majicdata6/ir_bingobox_2018/README.md

# ir_bingobox_2018
Infrared learning and sending.
