majicdata6/ir_bingobox_2018/project/Prudoction/[BingoBin]产品标贴制作说明书_171219.docx

档 号 | BGDC-518-01 | | 编 号 | BG-HRD18-0108025
保管期限 | 3年 | | 密 级 | 内部★
| | | 阶段标记 | V1.0.00

BingoBin网络功能模块

产品标贴制作说明书

## 1. 编写目的

本说明书定义了本产品使用标贴的制作规范。

本文档适用于公司员工。

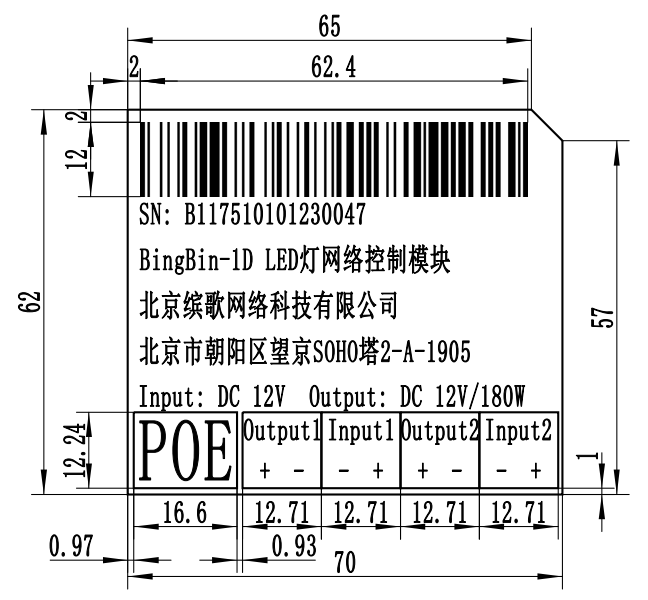
[picture p1: figure]

## 2. 标贴规格要求

### 2.1. 尺寸要求

图1

1、 尺寸：70 x 62 mm，右上角裁角。如图1所。
2、 条码：位置与尺寸如图1图示。要求如下：
- Code128-A规范
- 条码尺寸：62.4 x 12.0 mm
- 条码生成要求：只含条码（底部不带条码标签），居中对齐。如下图右图示，为正确格式。
- 位置：图1所示
- 条码内容与SN号相同
- 条码要求做流水号
- 参考：条码可以任选软件工具生成，遵循Code128规范即可。推荐使用Barcode Generator软件
3、 SN号：参考文档《[BingoBin]产品序列号编码说明书_171219》说明。例如B117510101230047，末六位做流水号处理，流水号段另见文件说明。
4、 流水号要求：要求保证条码内容与SN号相同。
5、 版本要求：参考提供的CAD样版文件。

### 2.2. 质量要求

1、 纸张材质：亚银龙
2、 工艺要求：
- 二次敷膜
- 背胶。温度要求：-40℃～+80℃

## 3. 文档编写

1、 编写者：开发部 朱海峰
2、 编写日期：2017年12月19日

## 4. 附录

### 4.1. 参考资料

1、 《[BingoBin]产品标贴样版_171219》
2、 《[BingoBin]产品SN号编码说明书_171219》
