majicdata6/ir_bingobox_2018/project/Prudoction/PCB制板/[BingoBin]PCB加工说明_180108.docx

档号 | BGDC-518-01 | | 编号 | BG-HRD18-0108005
保管期限 | 3年 | | 密级 | 内部★
| | | 阶段标记 | V1.0.00

# PCB加工说明表

BingoBin

文 件 名 | [BingoBin]HW_V1.0.10_180108.PcbDoc | 字 节 数 | 5317KB
设计软 件 | □Allegro □protel99 □protel 99SE □PADS □powerPCB ■DXP14 □AutoCAD □其它： | 表 面 处 理 | ■无铅喷锡 □镀金：oz
板 层 数 | □单面板 ■双面板 □多层板： | 插 头 镀 金 | □是 ■否
叠 层 顺 序 （多层板） | Layer1: Top Layer2: Bottom | 阻 焊 层 | □不涂阻焊剂 ■顶层阻焊 ■底层阻焊
| | 字 符 层 | □不印字符 ■顶层字符 ■底层字符
板 材 型 号 及基铜 | ■FR-4 □聚四氟乙稀 □Rogers □其它： | 外 形 公 差 | ■±0.15mm □0～—0.3mm □其它：mm
| 基 铜： ■无要求； □um | 制 板 数 量
板 厚 | 1.6 mm +/-10% | 下 单 日 期
| | 交 货 日 期
备 注 | 1、 PCB板尺寸：参考[BingoBin]HW_V1.0.10_180108.PcbDoc文件； 2、 板厚1.6 mm； 3、 阻焊颜色绿色； 4、 双层字符印刷，字符颜色白色； 5、 没有阻抗控制要求； 6、 双面开窗过孔不塞孔，双面未开窗小于等于0.4mm过孔全部塞孔；
