majicdata6/ir_bingobox_2018/project/Prudoction/SMT/软件/ReadMe.txt

固件

注：
	1、在调整灯的等级时，任意两个亮度等级变化时间均为5s。1-5级，1级最暗，5级最亮。
	2、电表的通信参数：9600波特率，偶校验，1个停止位。
