majicdata6/ir_bingobox_2018/project/Prudoction/SMT/钢网文件/ReadMe.txt

两个钢网文件，仅为从PCB Layout图中提取出的单板钢网文件，未做拼板。
请SMT时根据实际情况使用。
