majicdata6/ir_bingobox_2018/project/Prudoction/[BingoBin]建议工程配置说明书_171219.docx

档 号 | BGDC-518-01 | | 编 号 | BG-HRD18-0108027
保管期限 | 3年 | | 密 级 | 内部★
| | | 阶段标记 | V1.0.00

BingoBin网络功能模块

建议工程配置说明书

## 1. 编写目的

本说明书定义了生产应用本产品时安装配置说明。

本文档适用于公司员工。

## 2. 建议工程配置


### 2.1. LED灯安装配置

参考上图，建议连接配置方式如下表示：

序号 | 线路 | 连接说明
1 | Input1/Output1 | 连接室内LED灯，包含平板灯x3，筒灯x1，雨棚灯x1
2 | Input2/Output2 | 连接室外灯箱

收银台软件端将按此建议配置方式进行软件设计。

## 3. 文档编写

1、 编写者：开发部 朱海峰
2、 编写日期：2017年12月19日

## 4. 附录

### 4.1. 参考资料

1、 《[BingoBin]硬件产品需求说明书_171108》
2、 《[BingoBin]产品需求变更说明书_171219》
