majicdata6/ir_bingobox_2018/project/Prudoction/产品/[BingoBin]产品目录说明书_171219.docx

档 号 | BGDC-518-01 | | 编 号 | BG-HRD08-0108004
保管期限 | 3年 | | 密 级 | 内部★
| | | 阶段标记 | V1.0.00

BingoBin网络功能模块

产品目录说明书

## 1. 编写目的

本说明书定义了本产品系列与型号说明。

本文档适用于公司员工。

## 2. 产品目录

BingoBin网络功能模块为系统产品，产品硬件设计上做了兼容设计，可以衍生出四款产品。产品目录如下表说明。

序号 | 名称 | 型号 | 说明
1 | BingoBin网络功能模块 | BingoBin或BingoBin-1 | 产品系列型号
2 | BingoBin网络功能模块 智能电表版 | BingoBin-1B
3 | BingoBin网络功能模块 LED灯控版 | BingoBin-1D
4 | BingoBin网络功能模块 门锁版 | BingoBin-1M
5 | BingoBin网络功能模块 烟雾检测版 | BingoBin-1Y

## 3. 文档编写

1、 编写者：开发部 朱海峰
2、 编写日期：2017年12月19日

## 4. 附录

### 4.1. 参考资料

1、 《[BingoBin]硬件产品需求说明书_171108》
2、 《[BingoBin]产品需求变更说明书_171219》
