majicdata6/ir_bingobox_2018/project/Prudoction/SMT/PCB丝印图/[BingoBin]丝印文件_V1.0.10_180108.docx

档号 | BGDC-518-01 | | 编号 | BG-HRD18-0108015
保管期限 | 3年 | | 密级 | 内部★
| | | 阶段标记 | V1.0.10

[BingoBin]丝印文件

# 1. Top Layer

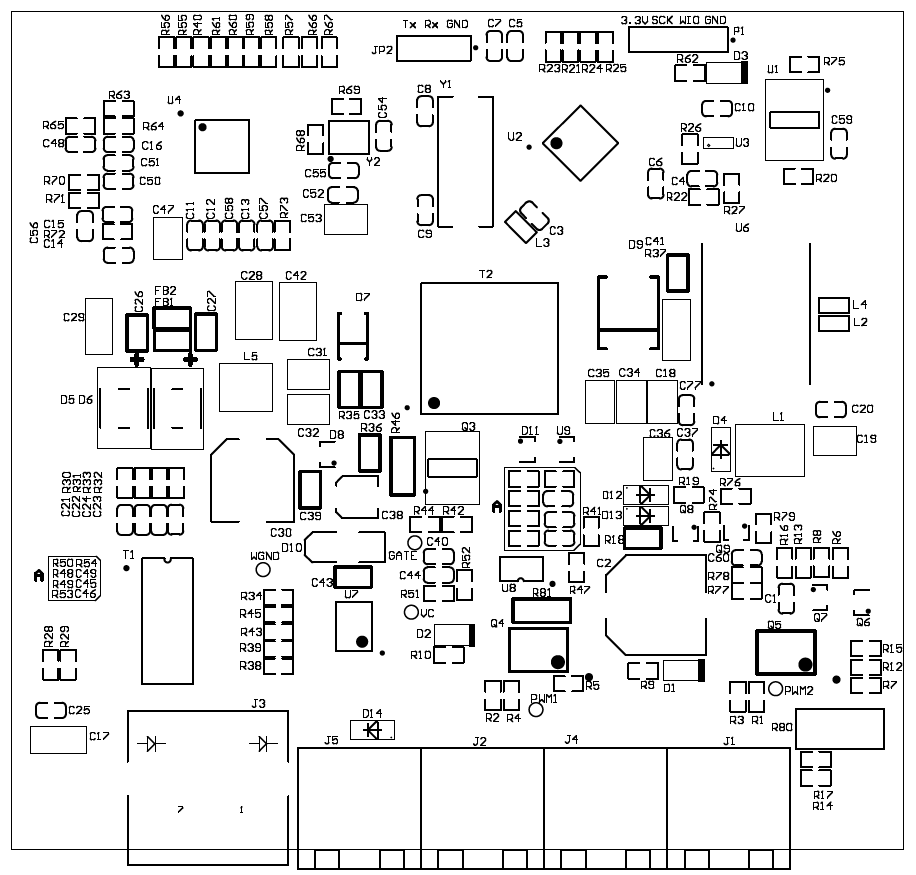
[picture p27: figure]

# 2. Bottom Layer

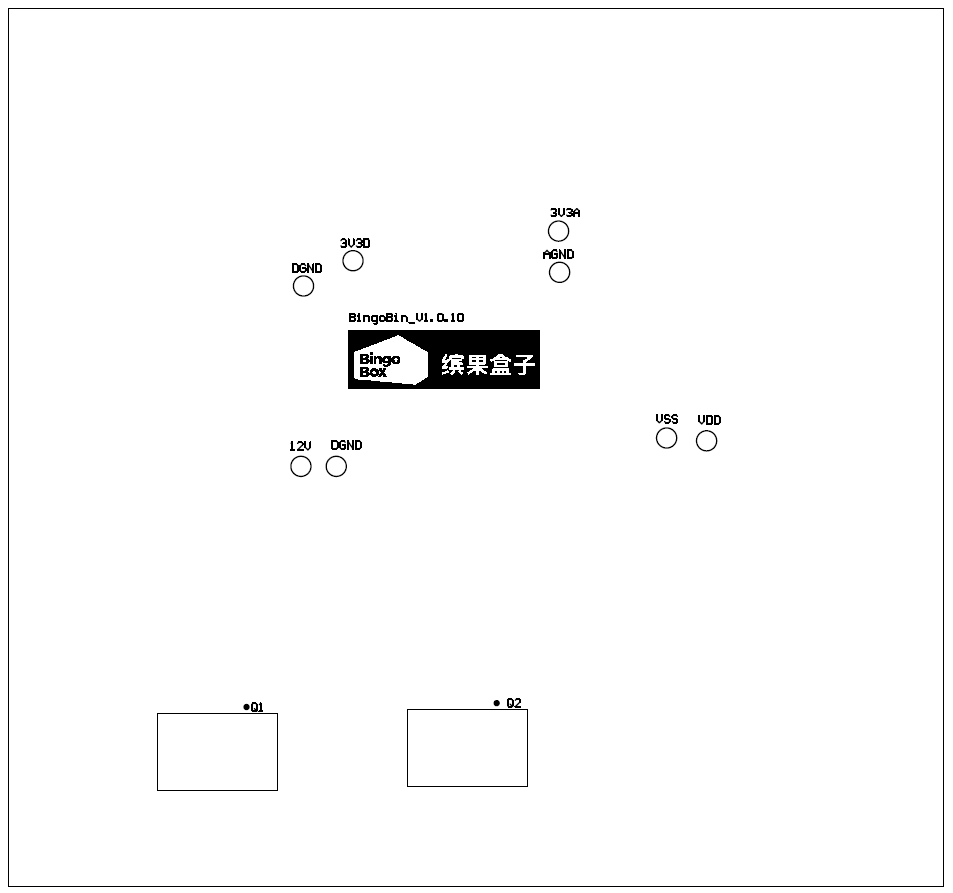
[picture p28: figure]
