majicdata6/ir_bingobox_2018/project/Prudoction/SMT/测试/[BingoBin]生产测试说明书_V1.0.00_180104.docx

档 号 | BGDC-518-01 | | 编 号 | BG-HRD18-0108018
保管期限 | 3年 | | 密 级 | 内部★
| | | 阶段标记 | V1.0.00

BingoBin网络功能模块

生产测试说明书

编写：开发部 朱海峰

序号 | 测试项目 | 测试说明 | 测试结果 | 备注
1 | 硬件短路测试 | 必测试项 万用表 对主板测试点进行短路测试 | 无任何短路现象即判断为合格 | 参考《[Bingobin]短路测试点说明_V1.0.10_180104》
2 | 上电测试 | 必测试项 电流表 对主板作瞬间上电操作 | 上电电流不超过30mA | 使用数字钳形电流表夹住POE网线
3 | 正式版软件测试 | 必测试项 主板烧录正式版软件，根据软件功能版本，按指导手册进行测试 | 指导手册测试荐全通过即判断为合格 | 参考《[BingoBin]生产测试指导手册_V1.0.10_180104》
