majicdata6/ir_bingobox_2018/project/Prudoction/SMT/坐标文件/[BingoBin]坐标文件_V1.0.10_180108.pdf

北京缤歌网络科技有限公司

第 1 页共 5 页

档号 | BGDC-518-01 | 编号 | BG-HRD18-0108016
保管期限 | 3 年 | 密级 | 内部★
| | 阶段标记 | V1.0.10

# [BingoBin]坐标文件

1. Top Layer
Designator | Mid X | Mid Y | Rotation
R10 | 1776mil | 790mil | 180.00
R6 | 3366mil | 1165mil | 90.00
C2 | 2617mil | 992mil | 0.00
C60 | 2985mil | 1185mil | 180.00
J3 | 798.189mil | 330mil | 270.00
C1 | 3146mil | 1019mil | 90.00
C59 | 3360mil | 2868mil | 90.00
C3 | 2123mil | 2575.999mil | 135.00
C4 | 2805.003mil | 2725.75mil | 180.00
C5 | 2045mil | 3265mil | 270.00
C6 | 2616mil | 2706mil | 90.00
C7 | 1960mil | 3265mil | 270.00
C8 | 1679mil | 3000mil | 90.00
C9 | 1679.291mil | 2597.992mil | 270.00
C10 | 2865.003mil | 3010.75mil | 180.00
C11 | 745mil | 2495mil | 270.00
C12 | 815mil | 2495mil | 270.00
C13 | 955mil | 2495mil | 270.00
C14 | 435mil | 2415mil | 180.00
C15 | 430mil | 2580mil | 180.00
C16 | 435mil | 2865mil | 180.00
C17 | 189.803mil | 445mil | 360.00
C18 | 2643mil | 1817.953mil | 90.00
C19 | 3342.953mil | 1660mil | 360.00
C20 | 3327.008mil | 1787.291mil | 360.00
C21 | 461mil | 1338.999mil | 270.00
C22 | 531mil | 1338.999mil | 270.00
C23 | 666mil | 1340mil | 270.00
C24 | 599mil | 1339mil | 270.00
C25 | 160mil | 565mil | 180.00
C26 | 510mil | 2098.598mil | 270.00
C27 | 789mil | 2101.598mil | 270.00
C28 | 984mil | 2188.772mil | 90.00
C29 | 357mil | 2126.197mil | 270.00
C30 | 979mil | 1499mil | 270.00
C31 | 1206.047mil | 1930mil | 180.00
C32 | 1206.047mil | 1787mil | 180.00

第 2 页共 5 页

C33 | 1461mil | 1869.598mil | 270.00
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
Y1 | 1843mil | 2795mil | 270.00
Y2 | 1370mil | 2893mil | 360.00
R5 | 2261mil | 673mil | 360.00
R81 | 2153.677mil | 972mil | 180.00
2. Bottom Layer
Designator | Mid X | Mid Y | Rotation
Q1 | 2857.953mil | 520mil | 270.00
Q2 | 1887.953mil | 535mil | 270.00

注意：坐标是以 PCB 板框左下角为基准点。
