majicdata6/ir_bingobox_2018/project/Design/SW/Doc/[BingoBin]测试用例大纲_V1.0.04.xlsx

测试用例 |  |  |  |  | 测试结果
3.功能测试
 | 3.1 供电测试
 |  | 3.1.1 POE供电测试
 |  | 3.1.2 外部供电测试
 | 3.2 网络通信测试
 |  | 3.2.1 心跳测试
 |  |  | 3.2.1.1 有心跳测试
 |  |  | 3.2.1.2 心跳时间间隔为5分钟
 | 3.3 设备操作测试
 |  | 3.3.1 读取设备信息测试
 |  | 3.3.2 更新IP测试
 | 3.4 外设功能测试
 |  | 3.4.1 采集环境温湿度功能测试
 |  |  | 3.4.1.1 采集环境温度信息
 |  |  |  | 3.4.1.1.1 -50℃温度采集测试
 |  |  |  | 3.4.1.1.2 -40℃温度采集测试
 |  |  |  | 3.4.1.1.3 20℃温度采集测试
 |  |  |  | 3.4.1.1.4 80℃温度采集测试
 |  |  |  | 3.4.1.1.5 100℃温度采集测试
 |  |  | 3.4.1.2 采集环境湿度信息
 |  |  |  | 3.4.1.2.1 0%RH湿度采集测试
 |  |  |  | 3.4.1.2.2 50%RH湿度采集测试
 |  |  |  | 3.4.1.2.3 99.9%RH湿度采集测试
 |  | 3.4.2 光传感器功能测试
 |  |  | 3.4.2.1 获取光照强度
 |  |  |  | 3.4.2.1.1 0 lux光照采集测试
 |  |  |  | 3.4.2.1.2 300 lux光照采集测试
 |  |  |  | 3.4.2.1.3 2000 lux光照采集测试
 |  |  |  | 3.4.2.1.4 10000 lux光照采集测试
 |  |  | 3.4.2.2 获取光照等级
 |  |  |  | 3.4.2.2.1 光强等级1测试
 |  |  |  | 3.4.2.2.2 光强等级3测试
 |  |  |  | 3.4.2.2.3 光强等级5测试
 |  | 3.4.3 人体红外传感器测试
 |  |  |  | 3.4.3.1人站在红外传感器正下方的有效检测范围测试
 |  |  |  | 3.4.3.2人站在红外传感器下方不确定的检测区域测试
 |  |  |  | 3.4.3.3人站在非有效检测区域测试
 |  | 3.4.4 LED灯测试
 |  |  | 3.4.4.1 打开LED
 |  |  |  | 3.4.4.1.1 POE供电打开LED灯
 |  |  |  | 3.4.4.1.2 外部供电打开LED灯
 |  |  | 3.4.4.2 关闭LED灯
 |  |  | 3.4.4.3 设置LED灯亮度等级
 |  |  |  | 3.4.4.3.1设置LED灯亮度为-1
 |  |  |  | 3.4.3.4.2设置LED灯亮度为0
 |  |  |  | 3.4.4.3.3设置LED灯亮度为1
 |  |  |  | 3.4.4.3.4设置LED灯亮度为3
 |  |  |  | 3.4.4.3.5设置LED灯亮度为5
 |  |  |  | 3.4.4.3.6设置LED灯亮度为6
 |  |  | 3.4.4.4 灯灭时查询LED灯状态信息
 |  | 3.4.5 门锁功能测试
 |  |  | 3.4.5.1 打开门锁
 |  |  | 3.4.5.2 关闭门锁
 |  |  | 3.4.5.3 设置自动关锁时间
 |  |  |  | 3.4.5.3.1 设置自动关锁时间(-1S)
 |  |  |  | 3.4.5.3.2 设置自动关锁时间(0S)
 |  |  |  | 3.4.5.3.3 设置自动关锁时间(4S)
 |  |  |  | 3.4.5.3.4 设置自动关锁时间(5S)
 |  |  |  | 3.4.5.3.5 设置自动关锁时间(60S)
 |  |  |  | 3.4.5.3.6 设置自动关锁时间(300S)
 |  |  |  | 3.4.5.3.7 设置自动关锁时间(301S)
 |  |  | 3.4.5.4 自动关锁测试
 |  |  |  | 3.4.5.4.1 自动关锁时间(6S)
 |  |  |  | 3.4.5.4.2 自动关锁时间(30S)
 |  |  | 3.4.5.5 查询门锁状态信息
 |  |  |  | 3.4.5.5.1 开门状态下，查询门锁状态信息
 |  |  |  | 3.4.5.5.2 关门状态下，查询门锁状态信息
 |  | 3.4.6 抄收电能表功能测试
 |  |  | 3.4.6.1 抄收电能设计(成功)
 |  |  | 3.4.6.2 抄收电能设计(失败)
 |  | 3.4.7 烟雾报警功能测试
 |  |  | 3.4.7.1 烟雾报警
 |  |  | 3.4.7.2 烟雾报警解除
 |  |  | 3.4.7.3 烟雾再次报警
 |  |  | 3.4.7.4 有烟雾每5分钟报警一次
4. 性能测试
 | 4.1 结构指标
 |  | 4.1.1 重量
 |  | 4.1.2 体积
5. 环境测试
 | 5.1 机械环境测试
 |  | 5.1.1 跌落（冲击）测试
 |  | 5.1.2 振动
 | 5.2 气候环境与可靠性测试
 |  | 5.2.1 高温测试
 |  |  | 5.2.1.1 贮存状态（不做）
 |  |  | 5.2.1.2 工作状态
 |  | 5.2.2 低温测试
 |  |  | 5.2.2.1 贮存状态（不做）
 |  |  | 5.2.2.2 工作状态
 |  | 5.2.3 温度冲击（不做）
 |  | 5.2.4 湿度（不做）
 |  | 5.2.5 防水测试（不做）
 | 5.3 特殊环境测试
 |  | 5.3.1 盐雾（不做）
 |  |  | 5.3.1.1 先决条件
 |  |  | 5.3.1.2 盐雾测试用例（不做）
