majicdata6/ir_bingobox_2018/project/Design/Feature/TB2vr54aV5N.eBjSZFKXXX_QVXa_!!1026500774.png

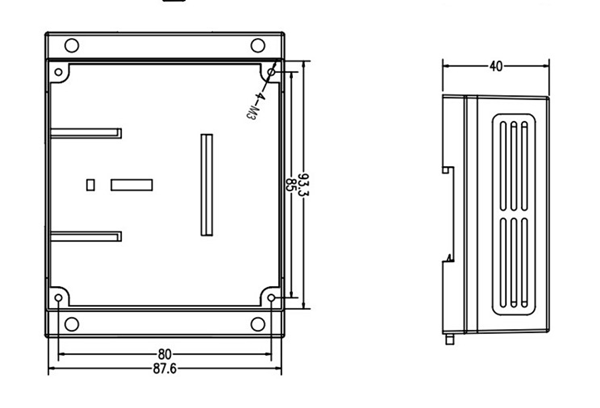
project/Design/Feature/TB2vr54aV5N.eBjSZFKXXX_QVXa_!!1026500774.png
