majicdata6/ir_bingobox_2018/project/Design/Feature/TB2xsKWa71M.eBjSZFOXXc0rFXa_!!1026500774.png

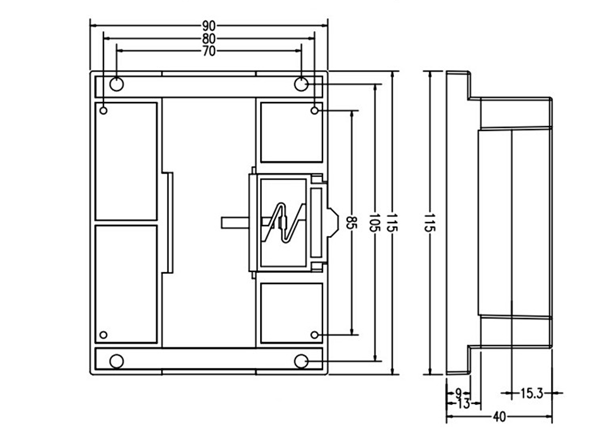
project/Design/Feature/TB2xsKWa71M.eBjSZFOXXc0rFXa_!!1026500774.png
