majicdata6/ir_bingobox_2018/project/Design/Feature/TB2ZWe0a71M.eBjSZFFXXc3vVXa_!!1026500774.png

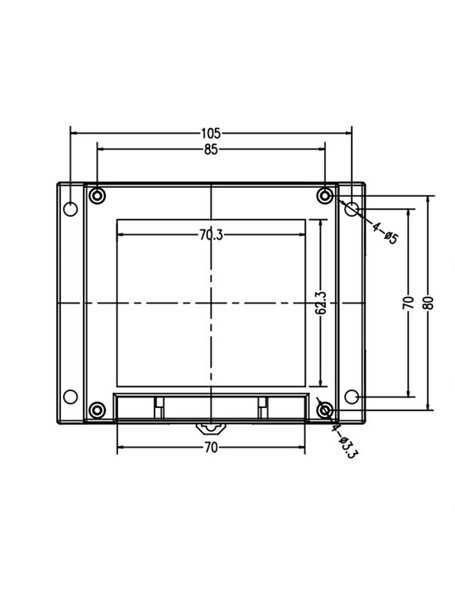
project/Design/Feature/TB2ZWe0a71M.eBjSZFFXXc3vVXa_!!1026500774.png
