majicdata6/ir_bingobox_2018/project/Design/Feature/TB20bi0a2OM.eBjSZFqXXculVXa_!!1026500774.png

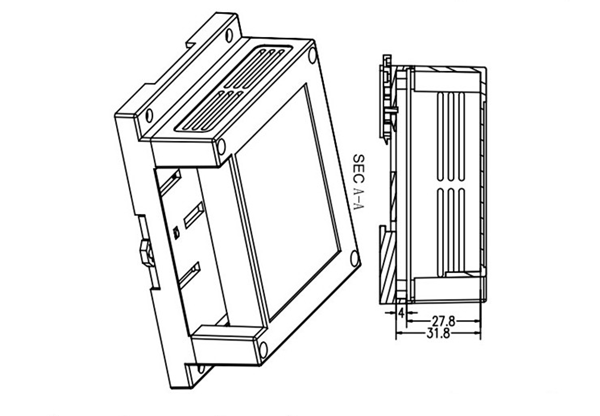
project/Design/Feature/TB20bi0a2OM.eBjSZFqXXculVXa_!!1026500774.png
