majicdata6/ir_bingobox_2018/project/Design/HW/Datasheet/上海联捷/LG635-6.35（拼接）.jpg

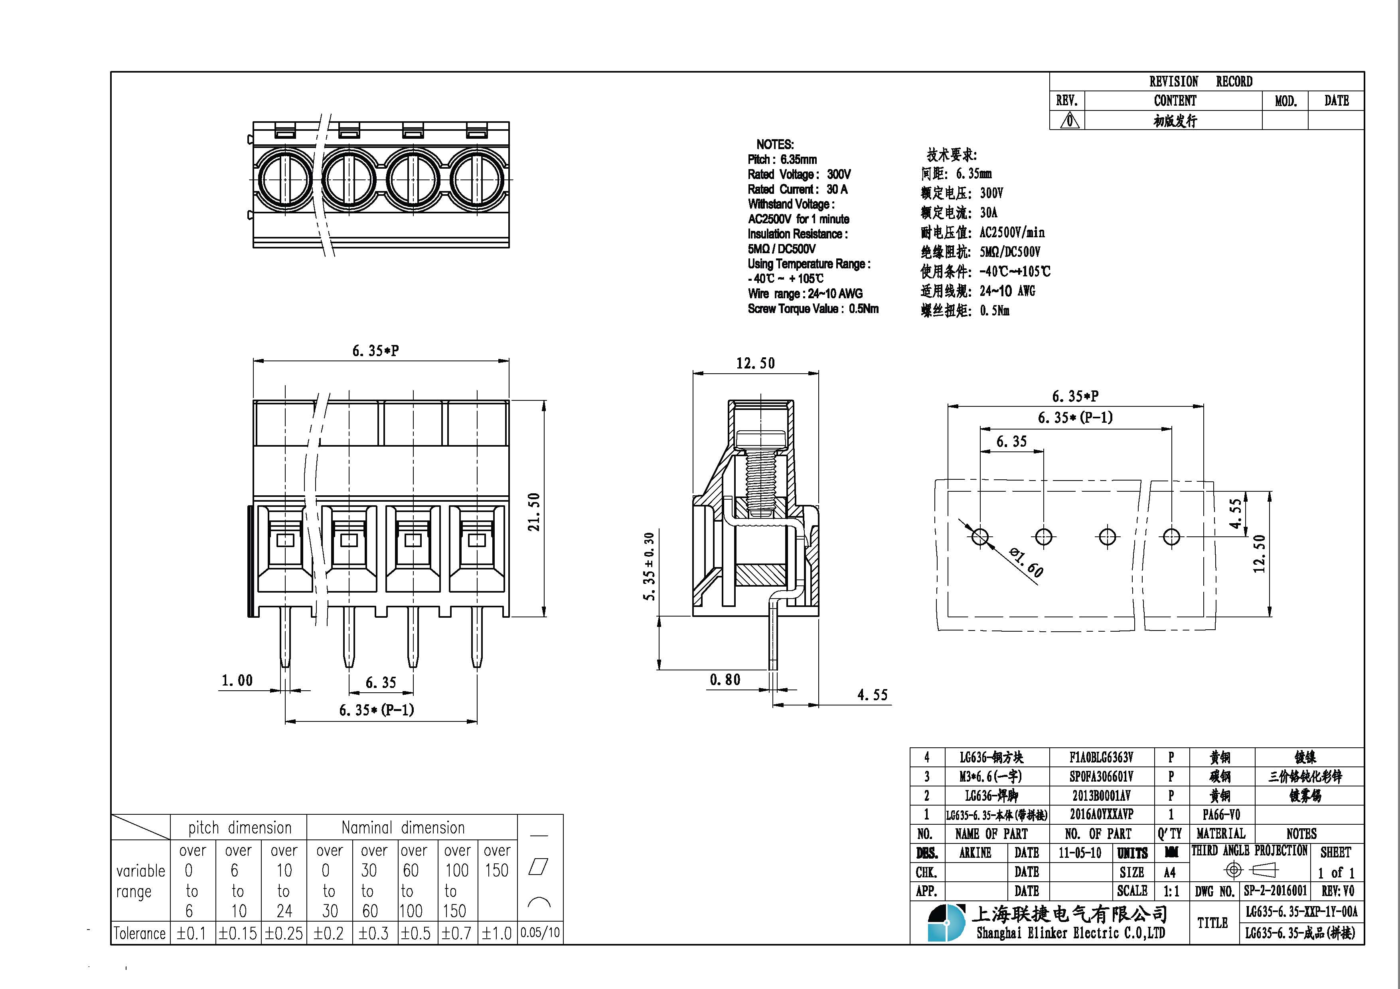
project/Design/HW/Datasheet/上海联捷/LG635-6.35（拼接）.jpg
