majicdata6/ir_bingobox_2018/project/Design/HW/Datasheet/上海联捷/LG762-7.62.jpg

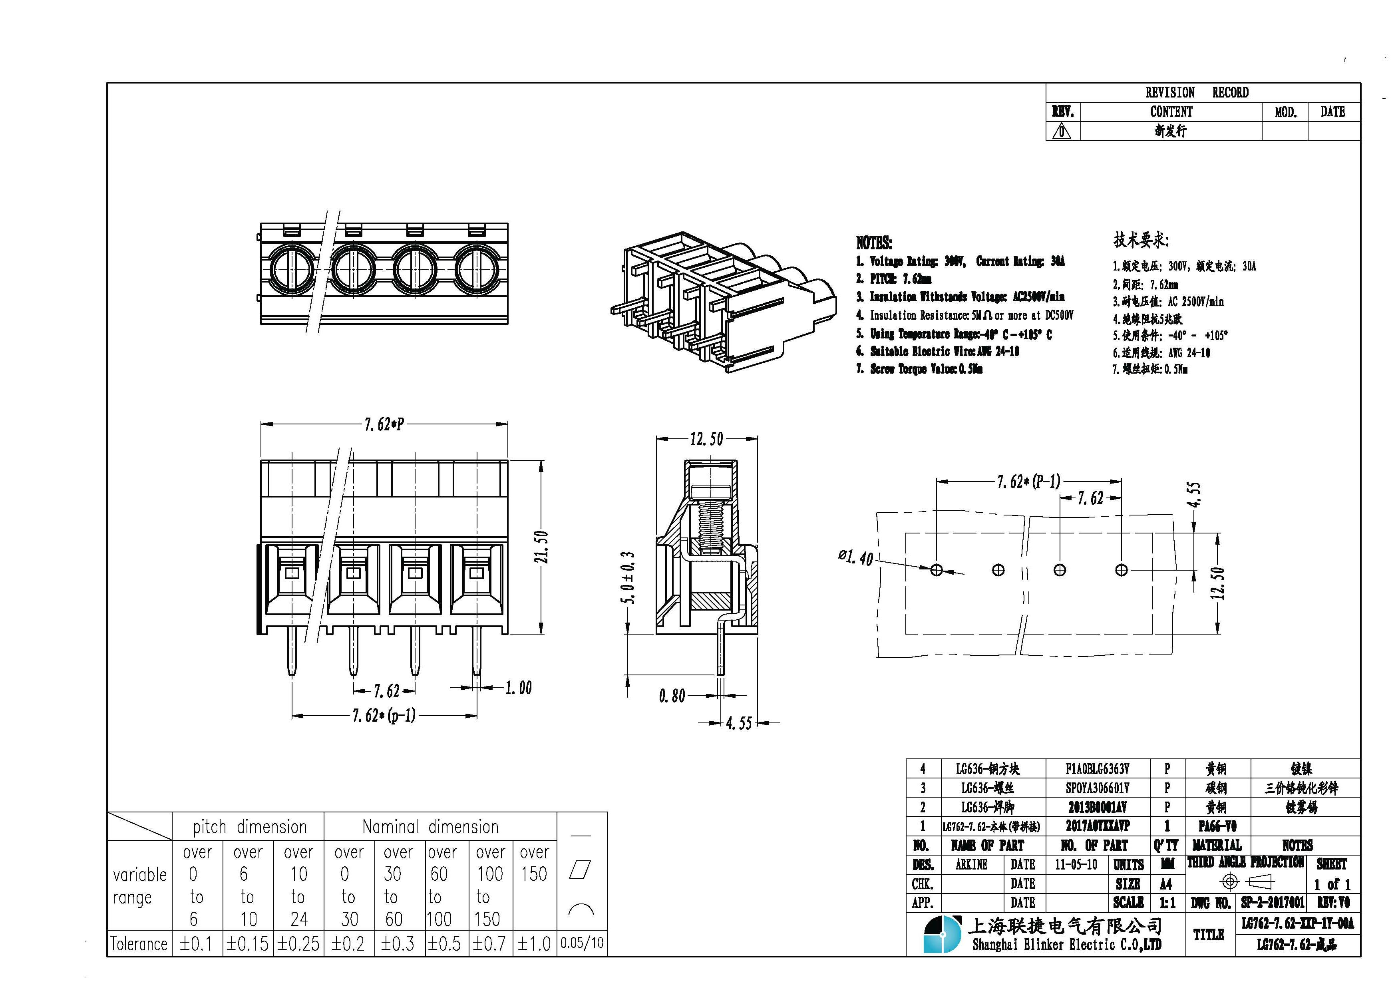
project/Design/HW/Datasheet/上海联捷/LG762-7.62.jpg
