majicdata6/ir_bingobox_2018/project/Design/HW/Datasheet/上海联捷/LG952-9.52（带拼接）.jpg

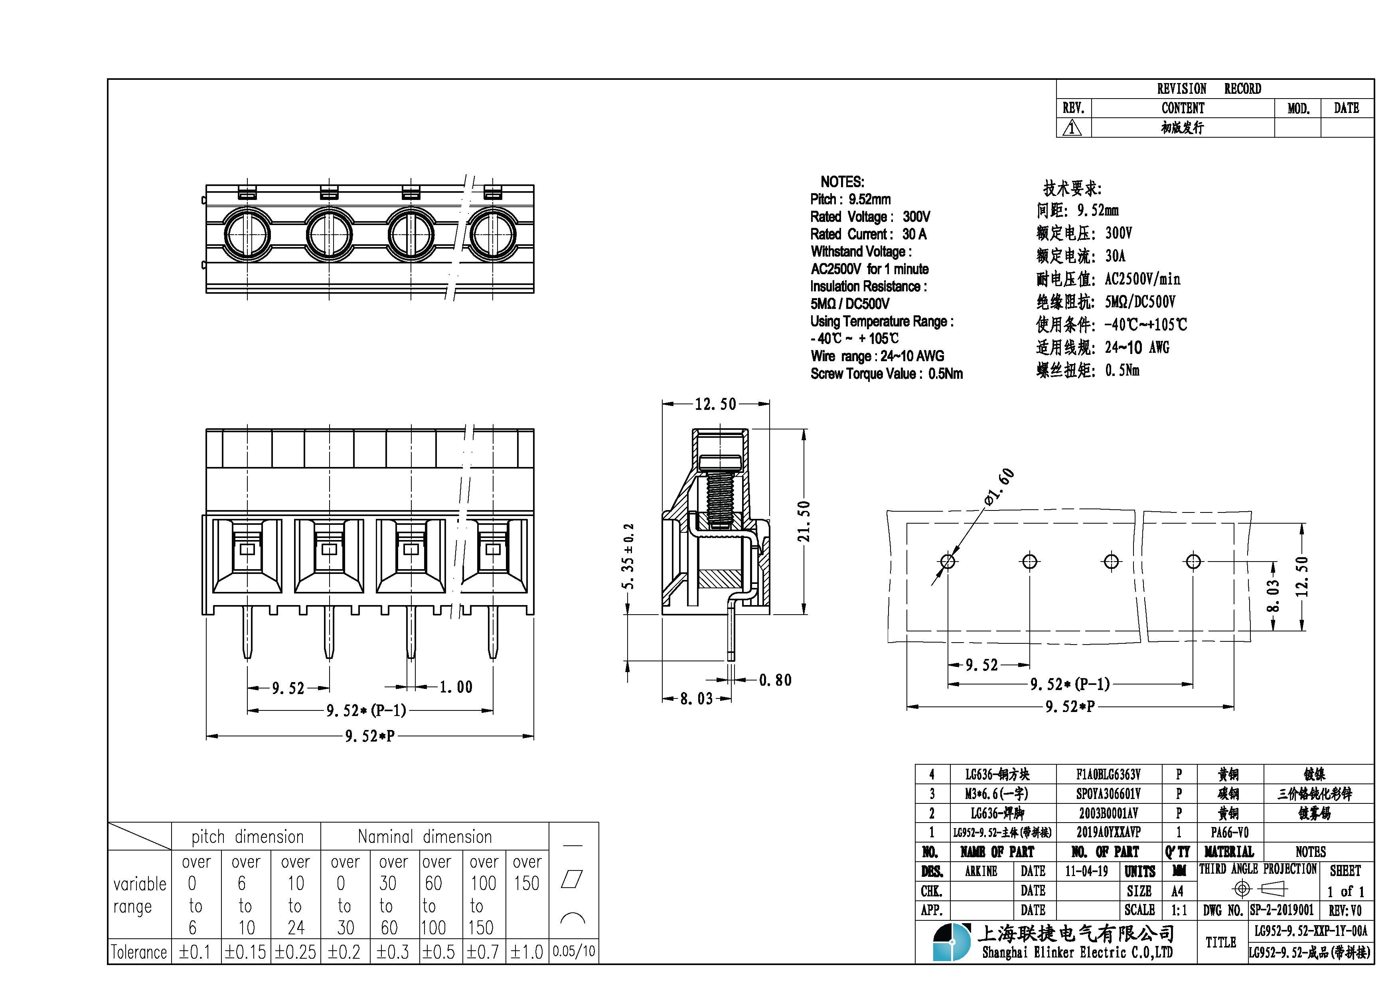
project/Design/HW/Datasheet/上海联捷/LG952-9.52（带拼接）.jpg
