majicdata6/ir_bingobox_2018/project/Design/HW/Datasheet/上海联捷/LW1C-11.0.jpg

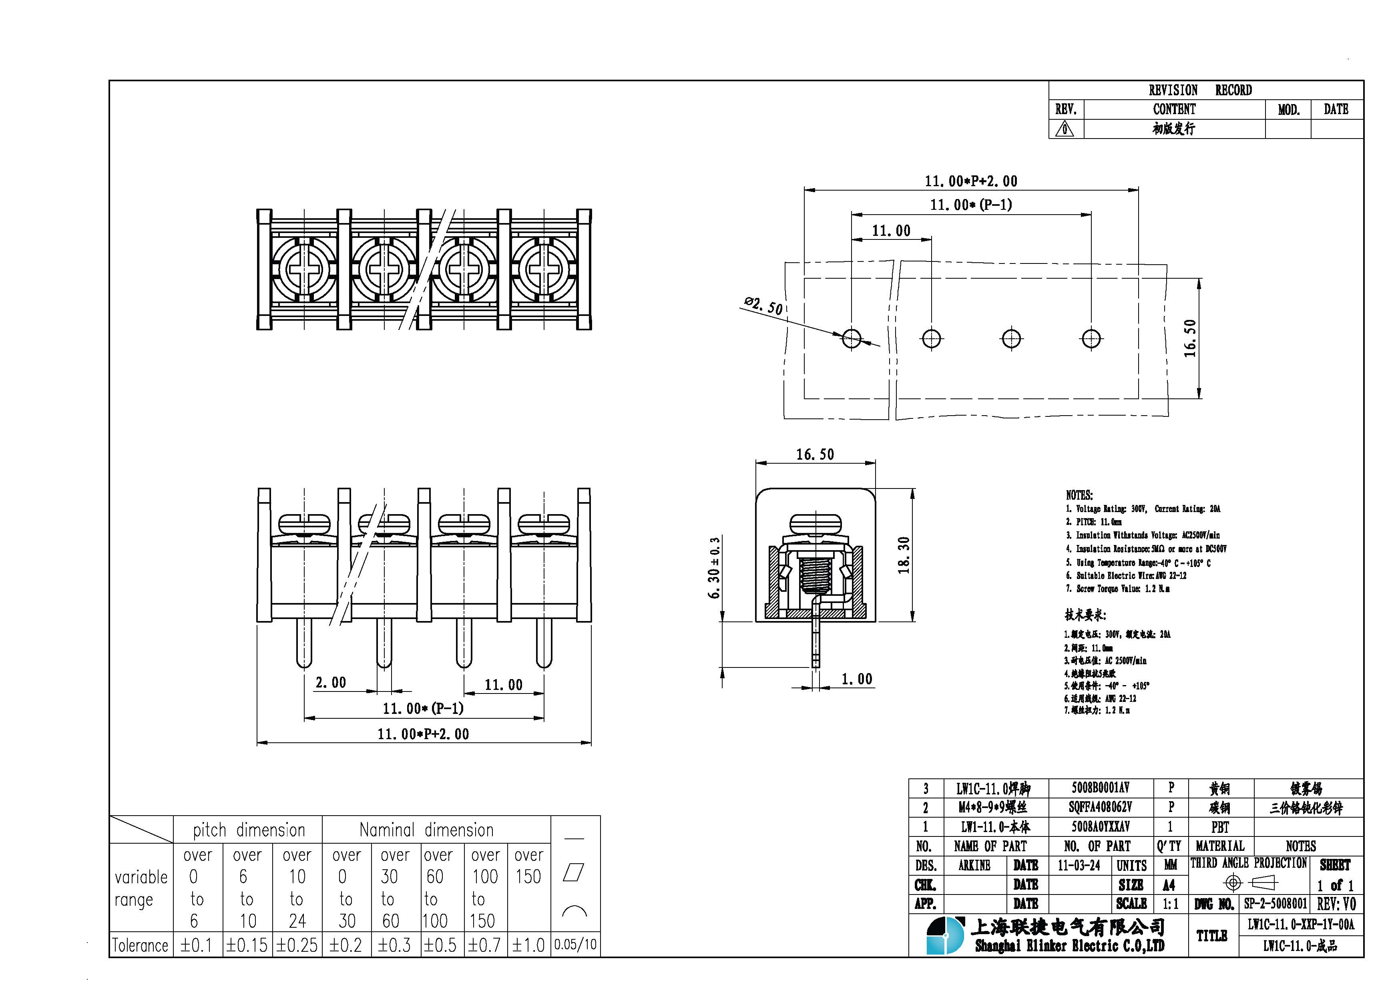
project/Design/HW/Datasheet/上海联捷/LW1C-11.0.jpg
