majicdata6/ir_bingobox_2018/project/Design/HW/Datasheet/上海联捷/联捷LG系列CE.jpg

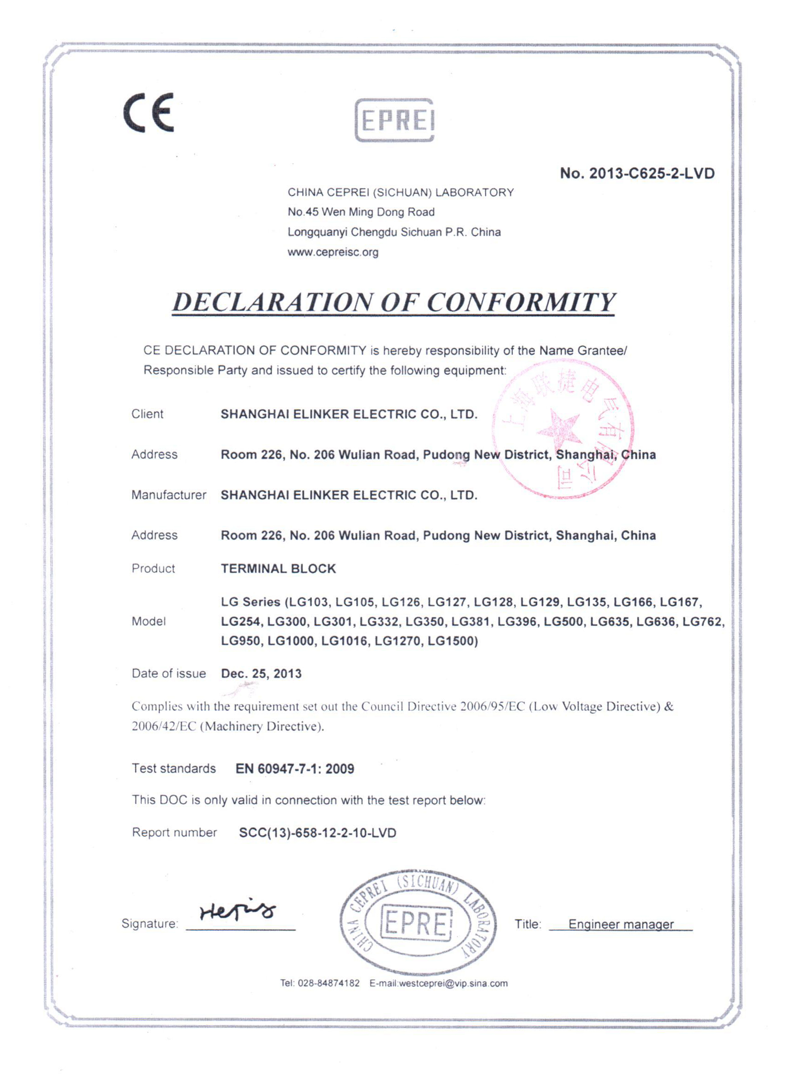
project/Design/HW/Datasheet/上海联捷/联捷LG系列CE.jpg
