majicdata6/ir_bingobox_2018/project/Design/HW/Doc/[BingoX]BOM_Model_170919.xlsx

[BingoBin]BOM
制作： |  |  |  |  |  |  |  |  | 日期：2017年9月19日
序号 | 类别 | 物料编号 | 物料名称 | 标号 | 型号/规格 | 封装 | 用量 | 厂商 | 厂商编码 | 厂商(替代料) | 厂商编码(替代料) | 厂商料号 | 备注
1 | 电子料 |  | 贴片电容 | C1, C37, C49 | Capacitor, Ceramic, 1uF, 25V, 10%, 0603, X7R | 0603 | 3 | muRata(村田) | GRM188R61E105KA12D
2 | 电子料 |  | 贴片电容 | C2, C8, C11, C13, C16, C20, C21, C22, C23, C24, C25,C40, C50, C51, C52, C56, C57, C58, C59, C60, C61, C66, C71, C72, C75, C76, C77 | Capacitor, Ceramic, 0.1uF, 16V, 10%, 0603, X7R | 0603 | 27 | AVX | 0603YC104KAT2A
3 | 电子料 |  | 贴片电容 | C21,C22,C23,C24 | Capacitor, Ceramic, 0.1uF, 100V, 10%, 0603, X7R | 0603 | 4 | muRata(村田) | GRM21BR72A104KAC4L
4 | 电子料 |  | 贴片电容 | C3, C7, C9, C10, C14, C46,C70, C73 | Capacitor, Ceramic, 0.01uF, 50V, 10%, 0603, X7R | 0603 | 8 | SAMAUNG(三星) | CL10B103KB8NNNC
5 | 电子料 |  | 贴片电容 | C5 | Capacitor, Ceramic, 10uF, 10V, 10%, 0603, X5R | 0603 | 1 | muRata(村田) | GRM188R61A106KE69D
6 | 电子料 |  | 贴片电容 | C6 | Capacitor, Ceramic, 5000pF, 50V, 10%, 0603, X7R | 0603 | 1 | FH(风华) | 0603B502K500NT
7 | 电子料 |  | 贴片电容 | C53 | Capacitor, Ceramic, 470nF, 16V, 10%, 0603, X7R | 0603 | 1 | SAMAUNG(三星) | CL10B474KO8NNNC
8 | 电子料 |  | 贴片电容 | C54, C55 | Capacitor, Ceramic, 22pF, 50V, 5%, 0603, COG | 0603 | 2 | 'muRata(村田) | GRM1885C1H220JA01D
9 | 电子料 |  | 贴片电容 | C63 | Capacitor, Ceramic, 22nF, 25V, 10%, 0603, X7R | 0603 | 1 | muRata(村田) | GRM188R71E223KA01D
10 | 电子料 |  | 贴片电容 | C68, C69 | Capacitor, Ceramic, 18pF, 50V, 5%, 0603, COG | 0603 | 2 | muRata(村田) | GRM1885C1H180JA01D
11 | 电子料 |  | 贴片电容 | C64, C65 | Capacitor, Ceramic, 6.8nF, 50V, 10%, 0603, X7R | 0603 | 2 | YAGEO(国巨) | CC0603KRX7R9BB682
12 | 电子料 |  | 贴片电容 | C12,C74 | Capacitor, Ceramic, 4.7uF, 16V, 10%, 0603, X7R | 0603 | 2 | muRata(村田) | GRM188R61C475KE11D
13 | 电子料 |  | 贴片电容 | C44 | Capacitor, Ceramic, 0.033uF, 50V, 10%, 0603, X7R | 0603 | 1 | SAMAUNG(三星) | CL10B333KB8NNNC
14 | 电子料 |  | 贴片电容 | C45 | Capacitor, Ceramic, 100pF, 50V, 5%, 0603, X7R | 0603 | 1 | muRata(村田) | GRM1882C1H101JA01D
15 | 电子料 |  | 贴片电容 | C33, C43 | Capacitor, Ceramic, 0.1uF,100V, 10%,0805,X7R | 0805 | 2 | muRata(村田) | GRM21BR72A104KAC4L
16 | 电子料 |  | 贴片电容 | C39 | Capacitor, Ceramic, 0.22uF,25V, 10%,0805,X7R | 0805 | 1 | SAMAUNG(三星) | CL21B224KAFNNNE
17 | 电子料 |  | 贴片电容 | C41 | Capacitor, Ceramic, 680pF,50V,5%,0805, NPO | 0805 | 1 | YAGEO(国巨) | CC0805JRNPO9BN681
18 | 电子料 |  | 贴片电容 | C26, C27, C47, C48 | Capacitor, Ceramic, 1000pF,100V, 10%,0805,X7R | 0805 | 4 | SAMAUNG(三星) | CL21B102KCANNNC
19 | 电子料 |  | 贴片电容 | C4, C18, C19, C34, C35, C36, C62, C67 | Capacitor, Ceramic, 22uF,16V, 10%,1210,X5R | 1210 | 8 | muRata(村田) | GRM32ER61C226KE20L
20 | 电子料 |  | 贴片电容 | C31, C32 | Capacitor, Ceramic, 2.2uF,100V, 10%,1210,X7R | 1210 | 2 | muRata(村田) | GRM32ER72A225KA35L
22 | 电子料 |  | 贴片电容 | C17, C29 | Capacitor, Ceramic Chip,1000pF, 2KV, 10%,1808 | 1808 | 2 | muRata(村田) | GR442QR73D102KW01L
23 | 电子料 |  | 贴片电容 | C28, C42 | Capacitor, Ceramic, 2200pF,2KV, 20%,1812,X7R | 1812 | 2 | muRata(村田) | GR443QR73D222KW01L
25 | 电子料 |  | 贴片铝聚合物电容 | C30 | Capacitor, Aluminum Electrolytic, 22uF,100V, 20% | 8*10.2mm | 1 | EEEFK1E100R | Panasonic
26 | 电子料 |  | 贴片铝聚合物电容 | C38 | Capacitor, Aluminum,10uF, 25V, 20% | 4*5.8 | 1 | EEEFK2A220P | Panasonic
26 | 电子料 |  | 贴片铝聚合物电容 | C80 | Capacitor, Aluminum Electrolytic, 470uF,16V, 20% | C8*10.2MM | 1
27 | 电子料 |  | 贴片电阻 | R1, R2, R4, R11, R20, R25, R26, R48, R53, R57, R58, R59, R67, R68, R74, R75, R76, R77, R78, R79, R80, R81, R82, R83 | RES, THICK FILM, 10K, 5%, 1/10W, 0603 | 0603 | 24 | YAGEO(国巨) | RC0603JR-0710KL
28 | 电子料 |  | 贴片电阻 | R6, R47, R51 | RES, THICK FILM, 2K, 5%, 1/10W, 0603 | 0603 | 3 | YAGEO(国巨) | RC0603JR-072KL
29 | 电子料 |  | 贴片电阻 | R3,R7, R12, R17,R69 | RES, THICK FILM, 1M, 5%, 1/10W, 0603 | 0603 | 6 | YAGEO(国巨) | RC0603JR-071ML
30 | 电子料 |  | 贴片电阻 | R8 | RES, THICK FILM, 470K, 5%, 1/10W, 0603 | 0603 | 1 | YAGEO(国巨) | RC0603JR-07470KL
31 | 电子料 |  | 贴片电阻 | R9 | RES, THICK FILM, 6.8K, 5%, 1/10W, 0603 | 0603 | 1 | YAGEO(国巨) | RC0603FR-076K8L
32 | 电子料 |  | 贴片电阻 | R5,R10, R14 | RES, THICK FILM, 18K, 1%, 1/10W, 0603 | 0603 | 3 | YAGEO(国巨) | RC0603FR-0718KL
33 | 电子料 |  | 贴片电阻 | R13, R24, R44,R56, | RES, THICK FILM, 1K, 5%, 1/10W, 0603 | 0603 | 4 | YAGEO(国巨) | RC0603JR-071KL
34 | 电子料 |  | 贴片电阻 | R18,R19, R21, R55, R84 | RES, THICK FILM, 4.7K, 5%, 1/10W, 0603 | 0603 | 5 | YAGEO(国巨) | RC0603JR-074K7L
 | 电子料 |  | 贴片电阻 | R85 | RES, THICK FILM, 10M, 5%, 1/10W, 0603 | R0603 | 1 | YAGEO(国巨) | RC0603FR-0710ML
 | 电子料 |  | 贴片电阻 | R86 | RES, THICK FILM, 1.5M, 5%, 1/10W, 0603 | R0603 | 1 | YAGEO(国巨) | RC0603JR-071M5L
 | 电子料 |  | 贴片电阻 | R95 | RES, THICK FILM, 2.2K, 5%, 1/8W, 0805 | 0805 | 1 | YAGEO(国巨) | RC0603JR-072K2L
36 | 电子料 |  | 贴片电阻 | R27 | RES, THICK FILM, 120 OHM, 5%, 1/10W, 0603 | 0603 | 1 | YAGEO(国巨) | RC0603JR-07120RL
37 | 电子料 |  | 贴片电阻 | R15 | RES, THICK FILM, 47K, 1%, 1/10W, 0603 | 0603 | 1 | YAGEO(国巨) | RC0603FR-0747KL
38 | 电子料 |  | 贴片电阻 | R61, R62 | RES, THICK FILM, 680 OHM, 5%, 1/10W, 0603 | 0603 | 2 | YAGEO(国巨) | RC0603JR-07680RL
39 | 电子料 |  | 贴片电阻 | R64, R65 | RES, THICK FILM, 49.9 OHM, 1%, 1/10W, 0603 | 0603 | 2 | YAGEO(国巨) | RC0603FR-0749R9L
40 | 电子料 |  | 贴片电阻 | R28, R29 | RES, THICK FILM, 330 OHM, 5%, 1/10W, 0603 | 0603 | 1 | YAGEO(国巨) | RC0603JR-07330RL
41 | 电子料 |  | 贴片电阻 | R73 | RES, THICK FILM, 12.4K, 1%, 1/10W, 0603 | 0603 | 1 | UniOhm台湾厚声 | 0603WAF1242T5E
42 | 电子料 |  | 贴片电阻 | R71, R72 | RES, THICK FILM, 82 OHM, 5%, 1/10W, 0603 | 0603 | 2 | UniOhm台湾厚声 | 0603WAJ0820T5E
43 | 电子料 |  | 贴片电阻 | R23 | RES, THICK FILM, 100 OHM, 5%, 1/10W, 0603 | 0603 | 1 | YAGEO(国巨) | RC0603JR-07100RL
44 | 电子料 |  | 贴片电阻 | R30, R31, R32, R33 | RES, THICK FILM, 75 OHM, 1%, 1/10W, 0603 | 0603 | 4 | YAGEO(国巨) | RC0603FR-0775RL
45 | 电子料 |  | 贴片电阻 | R34 | RES, THICK FILM, 24.9K, 1%, 1/10W, 0603 | 0603 | 1 | UniOhm台湾厚声 | 0603WAF249JT5E
46 | 电子料 |  | 贴片电阻 | R38 | RES, THICK FILM, 59K, 1%, 1/10W, 0603 | 0603 | 1 | UniOhm台湾厚声 | 0603WAF5902T5E
47 | 电子料 |  | 贴片电阻 | R39 | RES, THICK FILM, 80.6K, 1%, 1/10W, 0603 | 0603 | 1 | UniOhm台湾厚声 | 0603WAF8062T5E
48 | 电子料 |  | 贴片电阻 | R40 | RES, THICK FILM, 392K, 5%, 1/10W, 0603 | 0603 | 1 | UniOhm台湾厚声 | 0603WAF3923T5E
49 | 电子料 |  | 贴片电阻 | R22, R41, R60, R63, R70 | RES, THICK FILM, 0 OHM, 1%, 1/10W, 0603 | 0603 | 5 | YAGEO(国巨) | AC0603FR-070RL
50 | 电子料 |  | 贴片电阻 | R42,R66 | RES, THICK FILM, 10 OHM, 5%, 1/10W, 0603 | 0603 | 2 | YAGEO(国巨) | RC0603JR-0710RL
51 | 电子料 |  | 贴片电阻 | R43 | RES, THICK FILM, 39.2K, 1%, 1/10W, 0603 | 0603 | 1 | UniOhm台湾厚声 | 0603WAF3922T5E
52 | 电子料 |  | 贴片电阻 | R45 | RES, THICK FILM, 90.9 OHM, 1%, 1/10W, 0603 | 0603 | 1 | UniOhm台湾厚声 | 0603WAF9092T5E
53 | 电子料 |  | 贴片电阻 | R50 | RES, THICK FILM, 44.2K, 1%, 1/10W, 0603 | 0603 | 1 | UniOhm台湾厚声 | 0603WAF4422T5E
54 | 电子料 |  | 贴片电阻 | R52 | RES, THICK FILM, 1.5K, 5%, 1/10W, 0603 | 0603 | 1 | YAGEO(国巨) | RC0603JR-071K5L
55 | 电子料 |  | 贴片电阻 | R54 | RES, THICK FILM, 11.5K, 1%, 1/10W, 0603 | 0603 | 1 | UniOhm台湾厚声 | 0603WAF1152T5E
56 | 电子料 |  | 贴片电阻 | R49 | RES, THICK FILM, 4.99K, 1%, 1/10W, 0603 | 0603 | 1 | YAGEO(国巨) | RC0603FR-074K99L
57 | 电子料 |  | 贴片电阻 | R35 | RES, THICK FILM, 39K, 1%, 1/8W, 0805 | 0805 | 1 | YAGEO(国巨) | RC0805FR-0739KL
58 | 电子料 |  | 贴片电阻 | R36 | RES, THICK FILM, 10 OHM, 1%, 1/8W, 0805 | 0805 | 1 | YAGEO(国巨) | RC0805FR-0710RL
59 | 电子料 |  | 贴片电阻 | R37 | RES, THICK FILM, 20 OHM, 5%, 1/2W, 2010 | 2010 | 1 | UniOhm台湾厚声 | 2010W2J0200T4S
60 | 电子料 |  | 贴片电阻 | R46 | RES, THICK FILM, 0.39 OHM, 1%, 3/4W, 2010 | 2010 | 1 | YAGEO(国巨) | PT2010FK-070R39L
61 | 电子料 |  | 插针 | JP2, JP4,JP7 | Header, 3-Pin, Single row | HDR1X3 | 3
62 | 电子料 |  | 插针 | JP5,JP6,JP8 | Header, 2-Pin, Single row | HDR1X2 | 3
63 | 电子料 |  | 被动式红外传感器 | J1 | 热释电传感器 | TO-5 | 1 | Winsen(炜盛) | RD624
64 | 电子料 |  | RJ45连接器 | J3 | RJ45连接器/RJ45网口连接器,8p8c,90°,黄-绿LED灯,镀金,带屏蔽 | RJ45LED | 1 | TE Connectivity | 2-406549-1 | CONNFLY | DS1128-09-S8B8X
65 | 电子料 |  | 电源插座 | J4 | DC005-2.5MM | 2.5mm | 1 | SOFNG(台湾硕方) | DC连接器/DC005-2.5MM A级
66 | 电子料 |  | 15EDG座 | J2,J8 | WJ15EDGVC-3.81-2P | 15EDG-2P | 2 |  | WJ15EDGVC-2P
67 | 电子料 |  | 烟雾传感器接口 | J5 | WJ15EDGVC-3.81-4P | 15EDG-4P | 1 |  | WJ15EDGVC-4P
68 | 电子料 |  | JTAG座 | J6 | JTAG | IDC14P-2.54 | 1
70 | 电子料 |  | LED | D2, D13 | 翠绿色 贴片LED ( Iv=220-270mcd @IF=5mA) | 0805 | 2 | 国星光电 | FC-2012UGK-520D5
71 | 电子料 |  | 贴片二极管 | D3 | Diode Schottky, 60V, 5A, SMC | SMC | 1 | DIODES | B560C-13-F
72 | 电子料 |  | 贴片二极管 | D4, D15 | Diode Schottky, 40V,1A | SOD123 | 2 | DIODES | 1N5819HW
73 | 电子料 |  | 桥式整流器 | D5, D6 | Bridge Rectifier, 100V, 0.8A, Glass Passivated, SMD | MINI DIP4 | 2 | DIODES | HD01
74 | 电子料 |  | 贴片二极管 | D7, D12 | Diode, Rectifier, 1A, 200V | SMA | 2 | On Semi | MURA120 | MDD | SS1200
75 | 电子料 |  | 贴片二极管 | D8 | Diode, Switching, 200mA, 75V, 225mW | SOT-23 | 1 | DIODES | BAS16-7 | LRC(乐山无线电) | LBAS16LT1G
76 | 电子料 |  | 贴片二极管 | D9 | Diode Schottky, 60V, 3A, SMC | SMC | 1 | DIODES | B360C-13-F | ON(安森美) | MBRS360T3G
77 | 电子料 |  | 贴片二极管 | D10 | Diode,Transient Voltage Suppressor,400W,58V | SMA | 1 | DIODES | SMAJ58A
78 | 电子料 |  | 贴片二极管 | D11 | Diode, Dual Schottky, 200mA, 30V | SOT-23 | 1 | DIODES | BAT54S
80 | 电子料 |  | 铁氧体磁珠 | FB1, FB2, FB3, FB4 | Bead, Ferrite, SMT, 220 Ohms, 3A | 0805 | 4 | TDK | MPZ2012S221A
81 | 电子料 |  | 电感 | L1 | 330uH功率电感 | 5*5mm | 1 | LC | SMNR5040-331MT
82 | 电子料 |  | 电感 | L5 | Inductor, SMT, 750mA, 350 milliohm,10uH | 4x4mm | 1 | Coilcraft | LPS4012-103ML | Sunlord(顺络) | SWPA4012S100M
83 | 电子料 |  | 铁氧体磁珠 | L2, L3, L4 | Bead, Ferrite, SMT, 120 Ohms, 3A | 0603 | 3 | muRata(村田) | BLM03AG121SN1D
84 | 电子料 |  | N-MOS管 | Q1, Q2 | MOSFET, N-ch, 40-V, 50A, 7 milliOhms | TO252 | 2 | ALPHA&OMEGA | AOD4184A
85 | 电子料 |  | N-MOS管 | Q3 | MOSFET, N-ch, 150-V, 4.1A, 66 milliOhms | SO8 | 1 | Fairchild | FDS2582
 | 电子料 |  | N-MOS管 | Q4 | MOSFET, N-ch, 30-V, 5.6A, 27 milliOhms | SOT-23 | 1 |  | CJ3400
87 | 电子料 |  | POE网络变压器 | T1 | XFMR, 1000 Base-T, Ratio 1:1 | 0.500 x 0.370 inch | 1 | Pulse | H2019
88 | 电子料 |  | 反激式变压器 | T2 | Transformer, Flyback For PoE, 12V, 1A | POE13P-12L | 1 | Coilcraft | POE13P-12L | HANRUN(汉仁) | HR051142
89 | 电子料 |  | IC | U1 | 红外传感信号处理器 | SOIC16 | 1 | TM(天微) | TM2291
90 | 电子料 |  | IC | U2 | LIGHT-TO-DIGITAL CONVERTER | TMB-6 | 1 | TAOS | TSL2561T
93 | 电子料 |  | IC | U5 | +3.3V Low Power Half-Duplex RS-485 Transceiver with 10Mbps Data Rate | SOIC8 | 1 | EXAR | SP3485EN-L/TR
94 | 电子料 |  | IC | U6 | SIMPLE SWITCHER® 1A Step-Down Voltage Regulator | TO-263-5 | 1 | TI | LM2575SX-3.3/NOPB
95 | 电子料 |  | IC | U7 | IC, IEEE 802.3af Integrated Primary Side Controller | TPS23753a | 1 | TI | TPS23753APW
96 | 电子料 |  | IC | U8 | IC, Photocoupler, 3750VRMS, 80-160% CTR | SSOP4 | 1 | Vishay | TCMT1107
97 | 电子料 |  | IC | U9 | IC, Shunt Regulator, 2.5V Ref, 36V, 100mA, 1% | SOT-23 | 1 | TI | TL431AIDBZR
98 | 电子料 |  | IC | U10 | 混合信号微控制器 | TSSOP-38 | 1 | TI | MSP430FR5727IDAR
99 | 电子料 |  | IC | U11 | TCP/IP嵌入式以太网控制器 | LQFP-48 | 1 | WIZnet | W5500
 | 电子料 |  | IC | U12 | 数字温湿度传感器 | AM2320 | 1 | 奥松电子 | AM2320
100 | 电子料 |  | IC | U13 | Watchdog timer circuit/1.6s | SOT23-5 | 1 | ST | STWD100NYWY3F
101 | 电子料 |  | 可变电阻器 | VR1, VR2, VR3 | 1M 精密可调电阻 | 3266 | 3 | Bochen(国盛科技) | 3266W-1-105LF
102 | 电子料 |  | 晶振 | Y1 | XTAL 3215 32.768KHz 12.5pF 10ppm 70K -40~85℃ | SMD_3215_2P | 1 | YXC | YST310S32.768KHz12.5pF10ppm
103 | 电子料 |  | 晶振 | Y2 | XTAL S3225 25M 12pF 10ppm 40R -20~70℃ | SMD-3225_4P | 1 | TXC(台湾晶技) | 7M25xxxxx3-EEE4S | EPSON(爱普生) | X1E000021013912
104 | 装配料 |  | 菲涅尔透镜 8002-2 | P11 | Fresnel lens | Fresnel lens | 1
