majicdata6/ir_bingobox_2018/project/Prudoction/[BingoBin]生产资料清单_180108.pdf

北京缤歌网络科技有限公司
BGDC-518-01 | 编 | 号 BG-HRD18-0108001
3年 | 密 | 级 | 内部★
阶段标记 | V1.0.00
序号 | 类别 | 文件名称 | 版本 | 更新日期 | 备注
1 | 产品 | 需求说明书 | [BingoBin]硬件产品需求说明书_171108.pdf | V1.0.00 | 2017.11.8
| | 需求变更说明书 | [BingoBin]产品需求变更说明书_171219.pdf | V1.0.00 | 2017.12.19
| | 目录说明书 | [BingoBin]产品目录说明书_171219.pdf | V1.0.00 | 2017.12.19
| | PCB制板 | [BingoBin]HW_V1.0.10_180108.PcbDoc | V1.0.10 | 2018.1.8
| | | [BingoBin]PCB加工说明_180108.pdf | V1.0.00 | 2018.1.8
| | BOM | [BingoBin-1B]BOM_180102.pdf | V1.0.00 | 2018.1.2
| | | [BingoBin-1B]电子料BOM_180102.pdf | V1.0.00 | 2018.1.2
| | | [BingoBin-1D]BOM_180102.pdf | V1.0.00 | 2018.1.2
| | | [BingoBin-1D]电子料BOM_180102.pdf | V1.0.00 | 2018.1.2
| | | [BingoBin-1M]BOM_180102.pdf | V1.0.00 | 2018.1.2
| | | [BingoBin-1M]电子料BOM_180102.pdf | V1.0.00 | 2018.1.2
| | | [BingoBin-1Y]BOM_180102.pdf | V1.0.00 | 2018.1.2
| | | [BingoBin-1Y]电子料BOM_180102.pdf | V1.0.00 | 2018.1.2
| | 原理图 | [BingoBin]硬件设计原理图_V1.0.10_180108.pdf | V1.0.10 | 2018.1.8
| | PCB丝印图 | [BingoBin]丝印文件_V1.0.10_180108.pdf | V1.0.10 | 2018.1.8
| | 坐标文件 | [BingoBin]坐标文件_V1.0.10_180108.pdf | V1.0.10 | 2018.1.8
| | 钢网文件 | [BingoBin]钢网文件TOP_V1.0.10_180108.GTP | V1.0.10 | 2018.1.8
| | | [BingoBin]钢网文件BOTTOM_V1.0.10_180108.GBP | V1.0.10 | 2018.1.8
3 | 软件 | 正式版软件 | [BingoBin-1B]Firmware_V1.1.10_180104.hex | V1.1.10 | 2018.1.4
| | | [BingoBin-1D]Firmware_V1.2.10_180104.hex | V1.2.10 | 2018.1.4
| | | [BingoBin-1M]Firmware_V1.3.10_180104.hex | V1.3.10 | 2018.1.4

硬件

2

档 号
保管期限

# BingoBin网络控制模块

# 生产资料清单

第 1 页，共 2 页

北京缤歌网络科技有限公司
BGDC-518-01 | 编 | 号 BG-HRD18-0108001
3年 | 密 | 级 | 内部★
阶段标记 | V1.0.00
序号 | 类别 | 文件名称 | 版本 | 更新日期 | 备注
3 | 软件 | 正式版软件 | [BingoBin-1Y]Firmware_V1.4.10_180104.hex | V1.4.10 | 2018.1.4
4 | 测试 | 产品测试软件 | BingoBin测试软件 - V1.0.01Setup.exe | V1.0.01 | 2018.1.8
| | 产品测试用例 | [BingoBin]测试用例_V1.0.05_180104.pdf | V1.0.05 | 2018.1.4
| | 产品测试记录表 | [BingoBin]测试记录表_V1.0.05_180104.pdf | V1.0.05 | 2018.1.4
| | 生产测试说明书 | [BingoBin]生产测试说明书_V1.0.00_180104.pdf | V1.0.00 | 2018.1.4
| | 短路测试点说明书册 [Bingobin]短路测试点说明手册_V1.0.00_180104.pdf | | V1.0.00 | 2018.1.4
| | 生产测试指导手册 | [BingoBin]生产测试指导手册_V1.0.00_180104.pdf | V1.0.00 | 2018.1.4
5 | 生产 | 焊接说明书 | [BingoBin]产品焊接说明书_V1.0.00_180108.pdf | V1.0.00 | 2018.1.8
| | 烧录软件 | STM32 ST-LINK Utility_v3.7.0.exe | V3.7.0 | 2018.1.4
| | 软件烧录手册 | [BingoBin]软件烧录操作手册_V1.0.00_180103.pdf | V1.0.00 | 2018.1.3
| | 烧录线制作手册 | [BingoBin]烧录线规格说明书_V1.0.00_180103.pdf | V1.0.00 | 2018.1.3
| | 使用手册 | [BingoBin]使用手册_171219.pdf | V1.0.00 | 2017.12.19
| | 标贴制作说明书 | [BingoBin]产品标贴制作说明书_171219.pdf | V1.0.00 | 2017.12.19
| | 标贴样版 | [BingoBin]产品标贴样版_171220.dwg | V1.0.00 | 2017.12.20 | CAD2007版
| | 序列号编码说明书 | [BingoBin]产品序列号编码说明书_171219.pdf | V1.0.00 | 2017.12.19
| | 工程配置说明书 | [BingoBin]建议工程配置说明书_171219 | V1.0.00 | 2017.12.19
研发 确认 | 制作： 审核： 批准： 日期： 日期： 日期：
档 | 号
保管期限

# BingoBin网络控制模块

# 生产资料清单

第 2 页，共 2 页
