majicdata6/ir_bingobox_2018/project/Prudoction/[BingoBin]生产资料清单_签署_180108.pdf

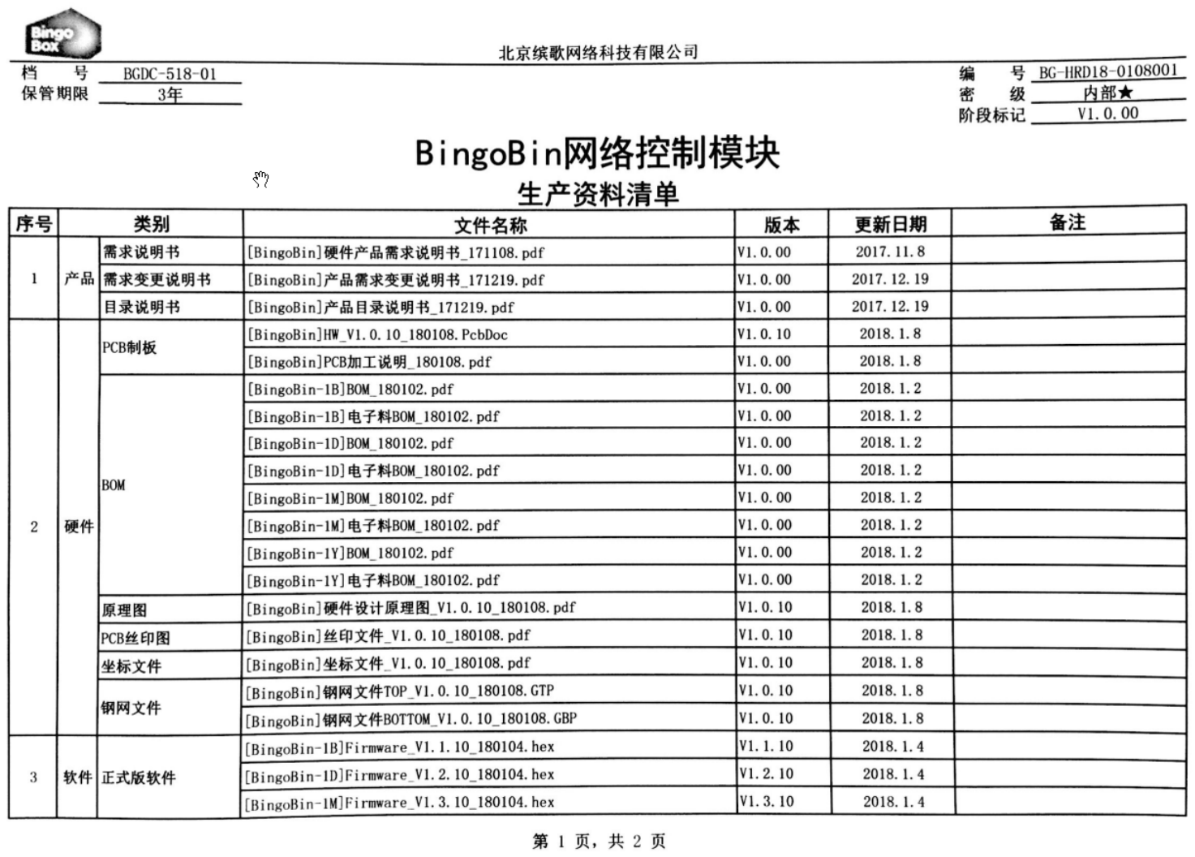
[picture p44: page 1]
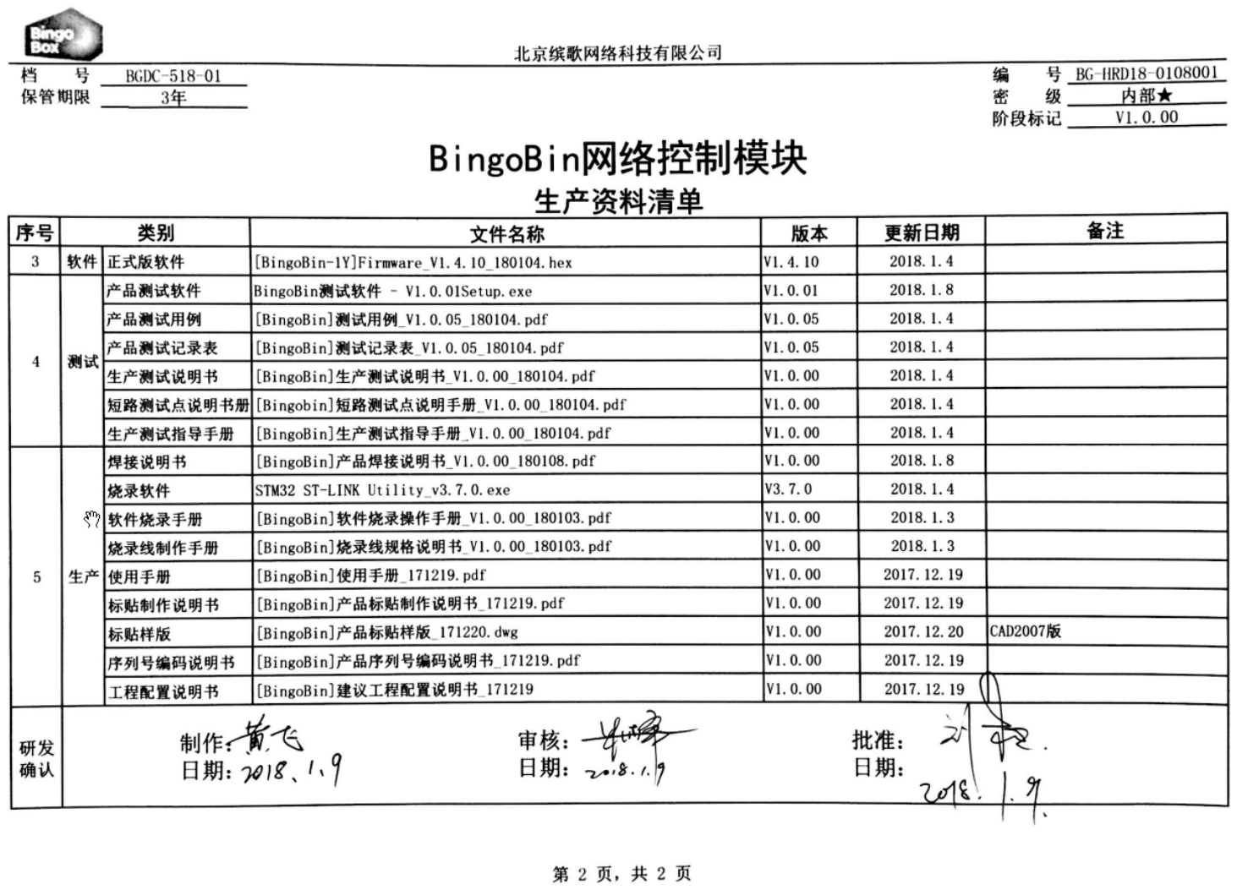
[picture p45: page 2]
