majicdata6/ir_bingobox_2018/project/Design/HW/Doc/[BingoBin]初样问题总结.xlsx

BingoBin初样问题记录
制表： |  |  |  |  | 日期：
序号 | 不良项 | 不良率 | 原因分析 | 拟改进措施 | 负责人 | 备注 | 第一次校验负责人 | 改进结果
1 | 电源插座J4丝印被遮挡且封装不对 | 100% | 封装错误 | 根据实物，修改元器件封装 | 张瑞 |  | 张瑞 | 修改
2 | 贴片二极管D4封装过大 | 100% | 封装过大 | 根据实物，修改元器件封装 | 张瑞 | 对应手册核实 | 张瑞 | 修改
3 | 电感L1封装过大 | 100% | 封装过大 | 根据实物，修改元器件封装 | 张瑞 | 对应手册核实 | 张瑞 | 修改
4 | JTAG封装引脚顺序错误 | 100% | 引脚顺序错误 | 正确改变封装引脚顺序 | 张瑞 |  | 张瑞 | 修改
5 | Ds18b20封装丝印错误 | 100% | 丝印是长方形，元器件超出板边界 | 替换成温湿度传感器,重新选型 | 张瑞 | AM2320（header3） | 张瑞 | 删除
6 | 有部分过孔未盖绿油 | 100% | 部分过孔没按要求设置 | 重新设置 | 张瑞 | 敷铜之后再查看 |  | 修改
7 | MARK点设置错误 | 100% | 设置错误 | 按要求重新设置 | 张瑞 |  |  | 修改
8 | 部分死铜未移除 | 100% | 有死铜 | 手动删除死铜 | 张瑞 |  |  | 修改
9 | WGND和DGND和覆铜十字形相连 | 100% | 覆铜规则只设置了和过孔和地直连 | 修改覆铜规则,使DGND和WGND的焊盘和覆铜直连 | 黄飞 |  |  | 修改
10 | HD01引脚顺序错误 | 100% | HD01的引脚定义和原理图引脚定义有出入 | 修改原理图的引脚连接 | 黄飞 |  | 张瑞 | 修改
11 | R45的阻值错误 | 100% | 制作原理图时把90.9Ω写成了90.9K | 修改原理图阻值标称,封装待确定 | 黄飞 |  | 张瑞 | 修改
12 | TCMT1107的PCB封装小 | 100% | pcb封装画的不合适 | 以实物为准,重新制作pcb封装 | 黄飞 | 对应手册核实 | 张瑞 | 修改
13 | TPS23753APW的CS引脚离R44远 | 100% | R44距离CS有点远 | 重新修改布局,使CS和R44连线短而粗 | 黄飞 |  |  | 修改
14 | POE13P-12L的引脚定义和pcb不符 | 100% | pcb封装错误 | 以实物为准,修改原理图和pcb封装 | 黄飞 | 对应手册核实 |  | 修改
15 | 增加一些测试点 | 100% | 对poe供电模块的理解不够 | 增加VC,VB,GATE,CTL测试点 | 黄飞 |  |  | 增加
16 | RJ45接口位置靠里 | 100% | 和外壳配合不好 | 重新测量外壳边沿和pcb的距离,使RJ45接口延伸到板外 | 黄飞 |  |  | 修改
17 | 插座引脚加上1脚标识 | 100% | 直插引脚没有标识 | 加上第一引脚标识 | 张瑞 | 封装1引脚所有 | 张瑞 | 修改
18 | 部分元器件没有丝印 | 2% | 缺少丝印标识 | 所有元器件都需加上丝印 | 张瑞 |  | 张瑞 | 修改
19 | TMP75C封装错误 | 100% | 封装型号与实物不同 | 修改封装 | 张瑞 | 移除此模块 |  | 移除
20 | 复位按键封装错误 | 100% | 封装有误 | 按照实物修改封装 | 张瑞 | 移除此模块 |  | 修改为过孔
21 | 外部晶振封装过大 | 100% | Y1封装错误 | 修改成32.768KHz晶振电路,备用 | 张瑞 |  | 张瑞 | 修改为3216封装
22 | 铜柱安装孔周边元器件密集 | 25% | PCB布局不合理 | 调整元器件布局，在过孔周边添加丝印 | 张瑞 | 间距,铜皮 |  | 修改
23 | 光感传感器INT引脚端口名称错误 | 100% | 端口名称标错 | 修改端口名称TSL2561_INT | 张瑞 | 光强封装稍微引脚加长,丝印 | 张瑞 | 修改
24 | 网络变压器和RJ45发送接收反了 | 100% | 原理图连接错误 | 修改原理图连接 | 黄飞 |  |  | 修改
25 | I2c和SPI的时钟和数据线增加测试点 | 100% | 为了更方便的调试 | 增加测试点 | 黄飞 | 正式版之后可以去掉 |  | 增加
26 | W5500的23,38,39,40,41,42引脚各串联一个10K电阻,然后接地 | 100% | 按照官方spc增加 | 修改原理图 | 黄飞 |  |  | 增加
27 | W5500的43,44,45各串联一个10K电阻,然后接地,同时和MCU相连 | 100% | 默认情况可以不焊接这几个电阻,同时可以通过程序进行控制 | 修改原理图 | 黄飞 |  |  | 增加
28 | 串口接口的两个TVS管去掉 | 100% | 以后不需要也,没必要加上 | 修改原理图 | 黄飞 |  | 张瑞 | 移除
29 | I2C上拉电阻大 | 100% | 改小 | 修改为4.7K | 黄飞 |  |  | 修改
30 | 烟雾传感器电路的R4位置不对 | 100% | 即使烟雾传感器拉低,MCU也检测不到低电平 | 把R4位置移动到MCU信号的入口 | 黄飞 |  |  | 修改
31 | 红外传感器的封装引脚反了 | 100% | 封装错误 | 修改红外传感器的封装 | 黄飞 |  | 张瑞 | 修改
32 | J2,J5,J8的位置靠板子里 | 100% | 位置稍微有点出入 | 参照盒子尺寸,PCB移动封装往板子边沿 | 黄飞 |  |  | 修改
33 | 被动式红外JP1去掉 | 100% | 无用 | 直接上拉连接 | 黄飞 |  |  | 移除
34 | 被动式红外的菲涅尔透镜的封装有一点点小 | 100% | 插入实物,有些松 | 重新修改封装,稍微大些 | 黄飞 |  | 张瑞 | 修改
35 | 所有电源入口的滤波电容放置到电源入口 | 20% | 布局和布线多注意 | 修改元器件布局 | 黄飞 |  |  | 修改
36 | POE布局,LDO布局重新调整 | 100% | 有些布局需要优化 | 修改元器件走线布局 | 黄飞 |  |  | 修改
37 | LDO上两个钽电容用陶瓷电容代替 | 100% | 成本高 | 降低成本 | 黄飞 |  |  | 修改
38 | W5500的两个钽电容也用相同容量的陶瓷电容代替 | 100% | 成本高 | 降低成本 | 黄飞 |  |  | 修改
39 | 增加一组NMOS管 | 100% |  | 重新选型,电流为2-5A,PWM复用 | 黄飞 |  |  | 增加
40 | 增加锁控模块 | 100% |  | ADC测电压,前端电容蓄能,开关复用LED的NMOS管 | 黄飞 |  |  | 增加
 | 直角走线 | 10% |  |  |  |  |  | 修改
 | 晶振下面有信号线 | 100% |  |  |  |  |  | 修改
 | 螺丝孔内径小 | 100% |  | 修改孔径为3.5*5.5 |  |  |  | 修改
