majicdata6/ir_bingobox_2018/project/Design/HW/Doc/[BingoBin]试样问题总结.xlsx

BingoBin试样问题记录
制表： |  |  |  |  | 日期：
序号 | 不良项 | 不良率 | 原因分析 | 拟改进措施 | 负责人 | 备注 | 第一次校验负责人 | 改进结果
1 | 电源插座J4丝印被遮挡且封装不对 | 100% | 封装错误 | 根据实物，修改元器件封装 | 张瑞 |  | 张瑞 | 修改
2 | R18的0603封装和其他的0603不统一 | 100% | 封装不统一 | 修改和其他0603电阻的一样 | 黄飞
3 | R46的封装大了 | 100% | 封装错误 | 根据实物，修改元器件封装 | 黄飞
4 | 温湿度传感器的顶层不要敷铜 | 100% | 上层敷铜也会有一定的热量 | 去掉温湿度顶层的敷铜 | 黄飞
5 | J1,红外传感器的封装标识错误 | 100% | 封装和实物的耳朵不对应 | 根据实物，修改元器件封装 | 黄飞
6 | J1的方向不对 | 100% | 红外传感器上方窗口和板子不平行 | 旋转红外传感器的方向 | 黄飞
7 | R18以后不焊接 | 100% | R18为了定义光传感器的从地址 | 就一个i2c的器件,没必要再通过R18设置一个i2c地址 | 黄飞
8 | J8接口未标出A、B线 | 50% | 485差分通信线有A、B线之分，接反通信失败 | 加上AB线标识 | 刘帅
