majicdata6/ir_bingobox_2018/project/Design/Feature/PCB板宽.dxf

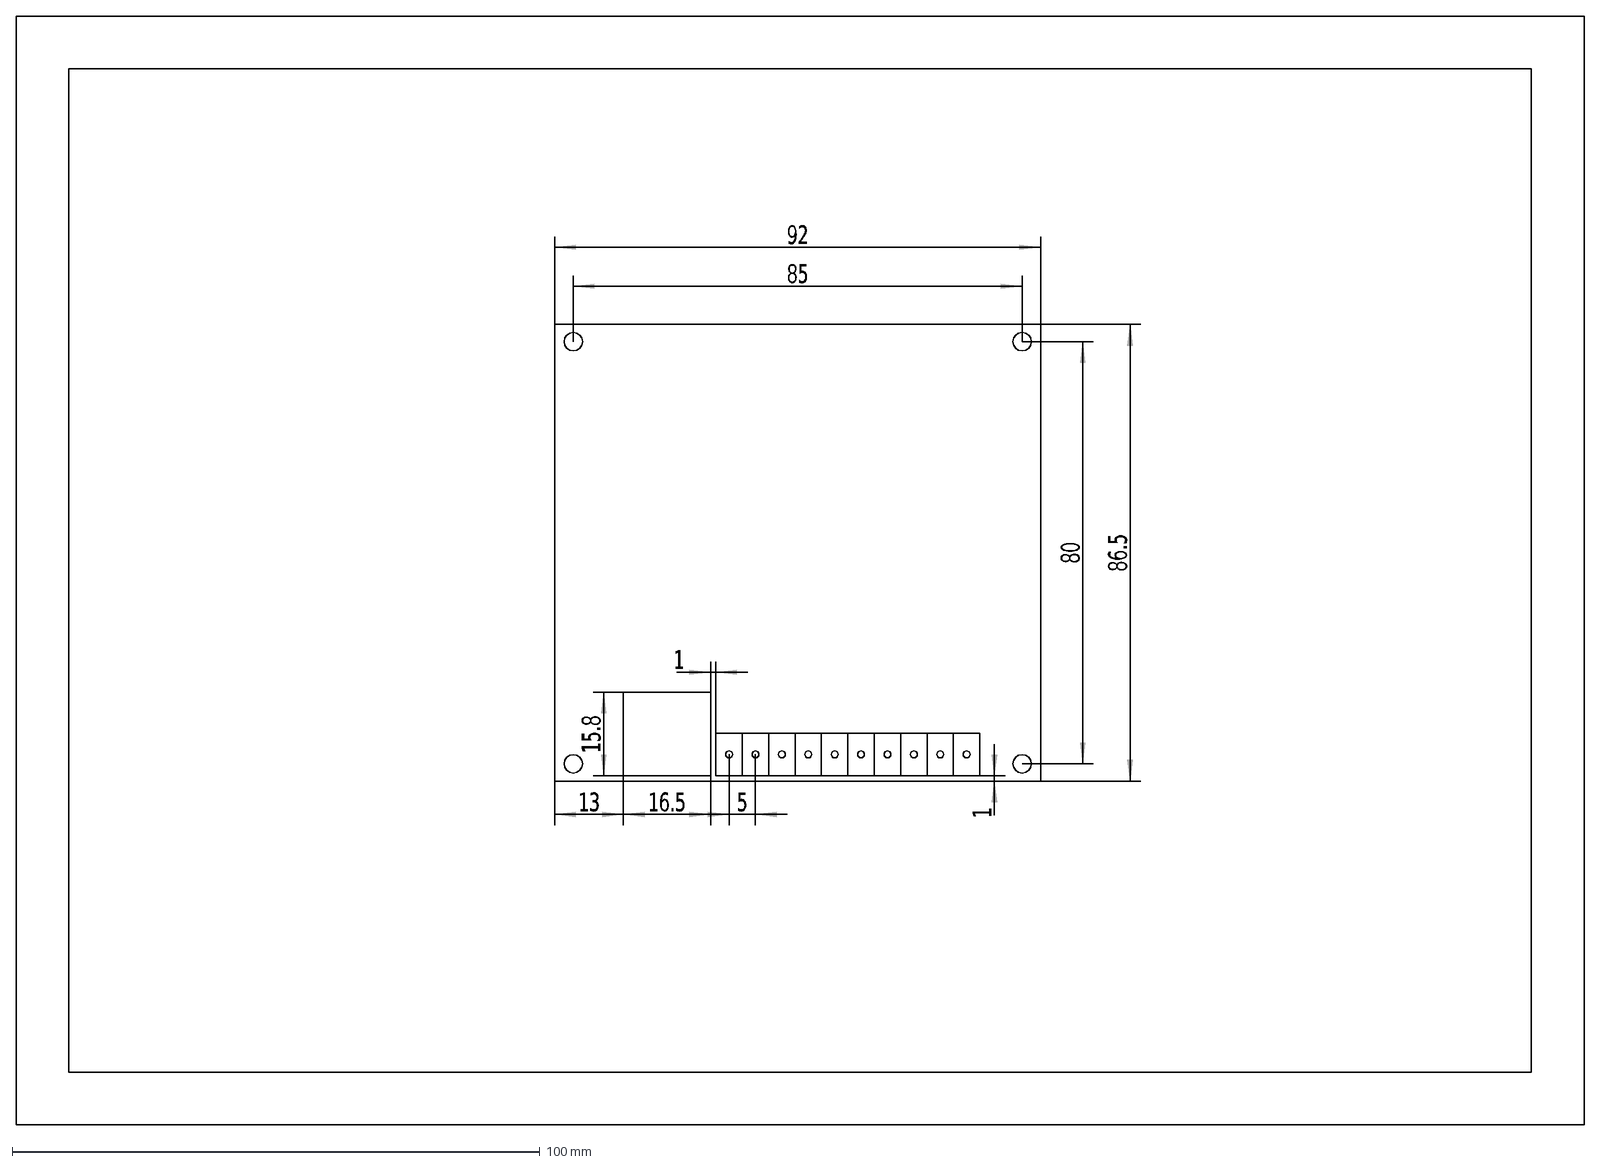
[picture p46: CAD file, 2018-03-03]
project/Design/Feature/PCB板宽.dxf
92
86.5
80
85
5
16.5
15.8
13
1
