majicdata6/ir_bingobox_2018/(list of files, cad)

Other CAD files:
project/Prudoction/[BingoBin]产品标贴样版_171220.dwg
project/Design/Feature/PNT-01.dwg
