majicdata6/ir_bingobox_2018/project/Prudoction/产品/[BingoBin]产品控制逻辑拓扑图_171222.pdf

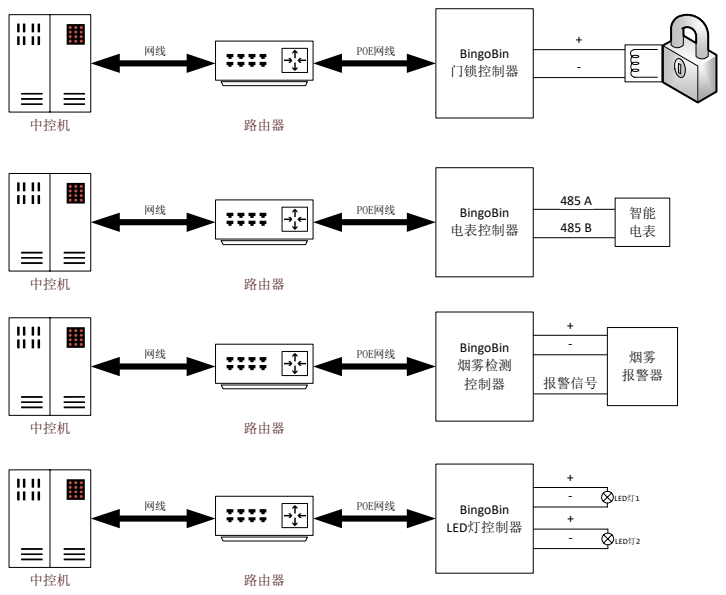
[picture p47: page 1]
报警信号; 中控机; 路由器; BingoBin; 门锁控制器; 电表控制器; BingoBin 烟雾检测 控制器; 烟雾 报警器; POE网线; BingoBin LED灯控制器; LED灯2; LED灯1
