majicdata6/ir_bingobox_2018/project/Design/Feature/PCB板宽.exb.pdf

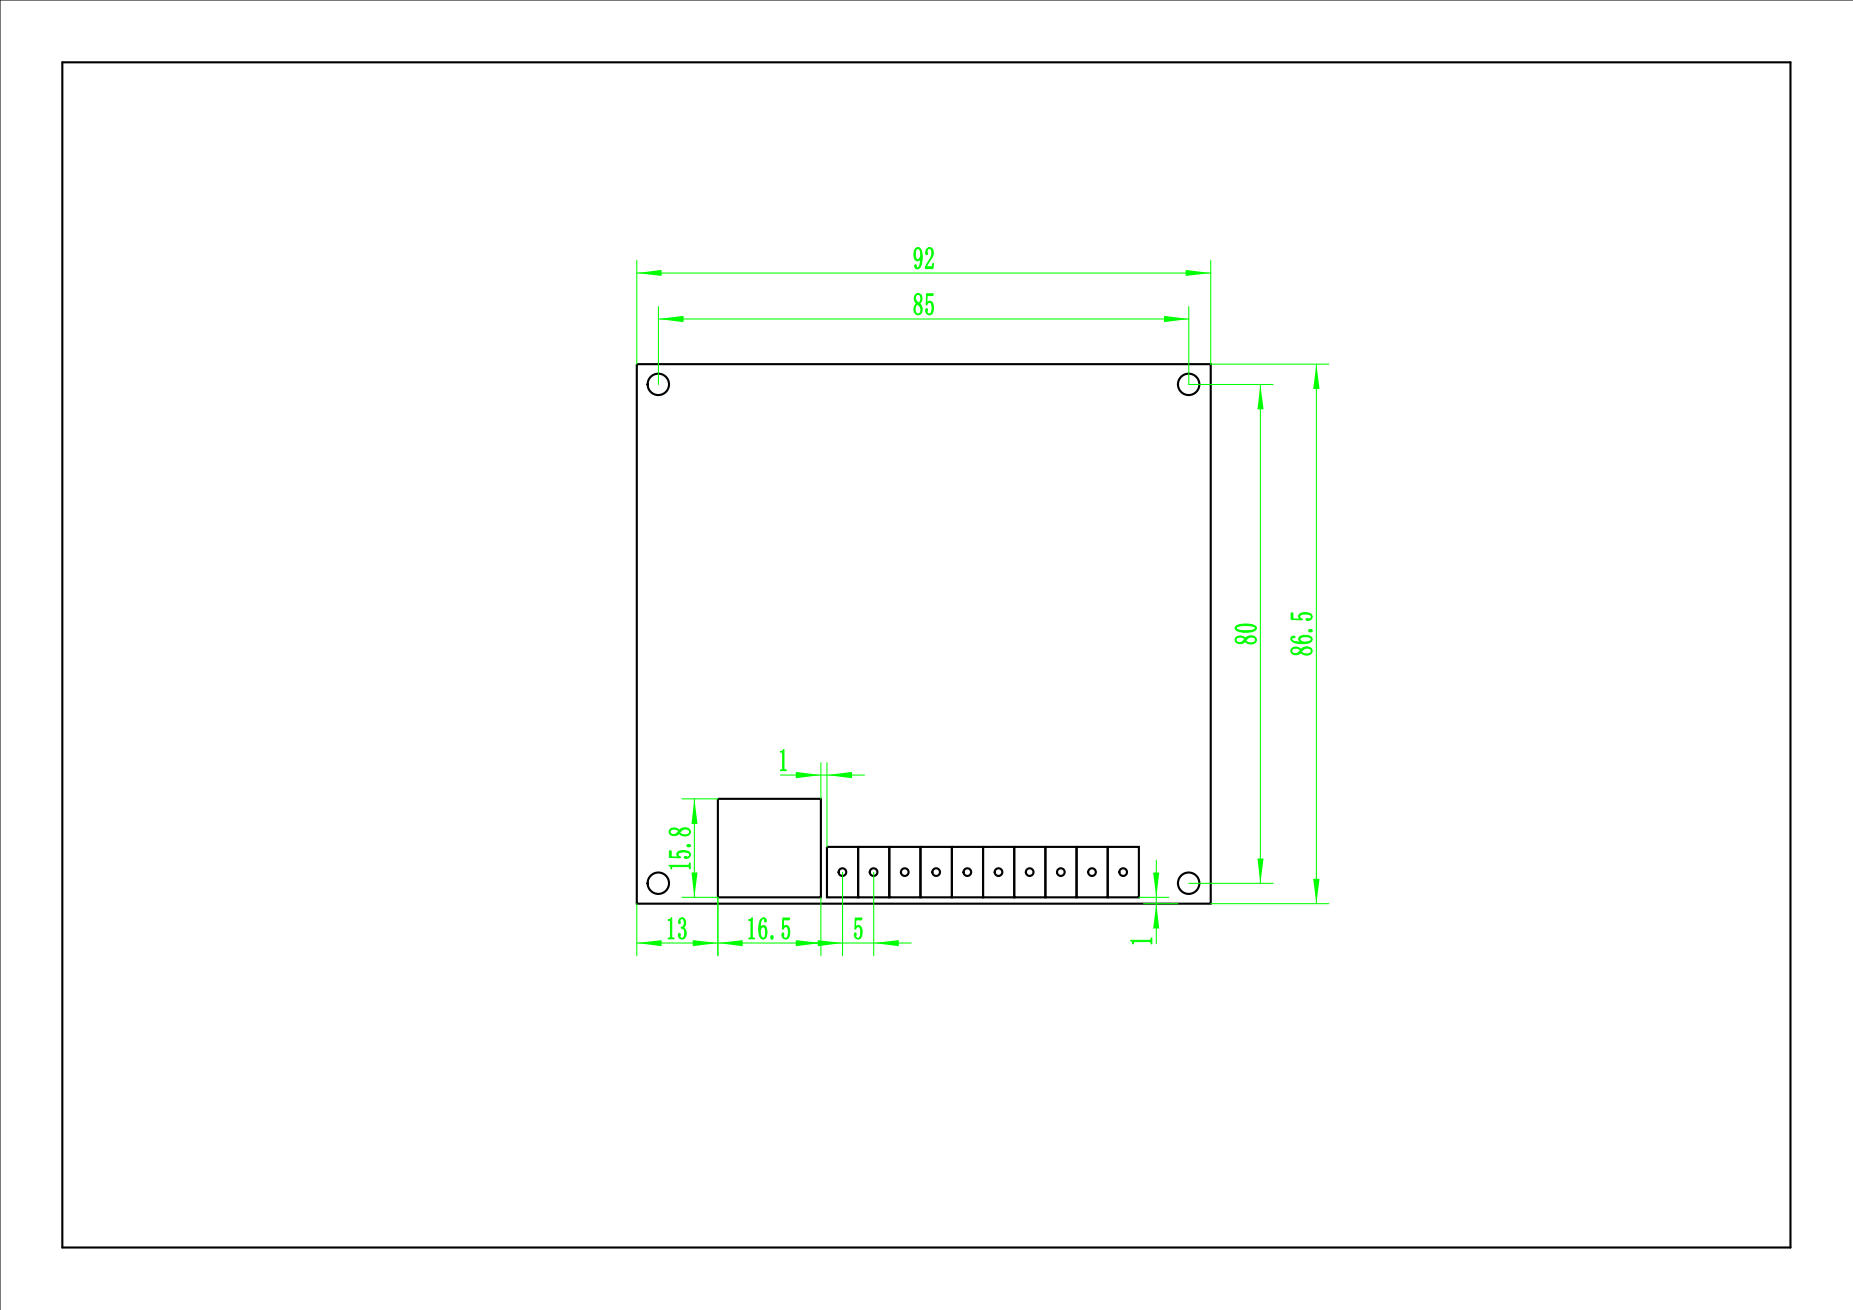
[picture p48: page 1]
