majicdata6/ir_bingobox_2018/project/Design/Feature/PNT-01.pdf

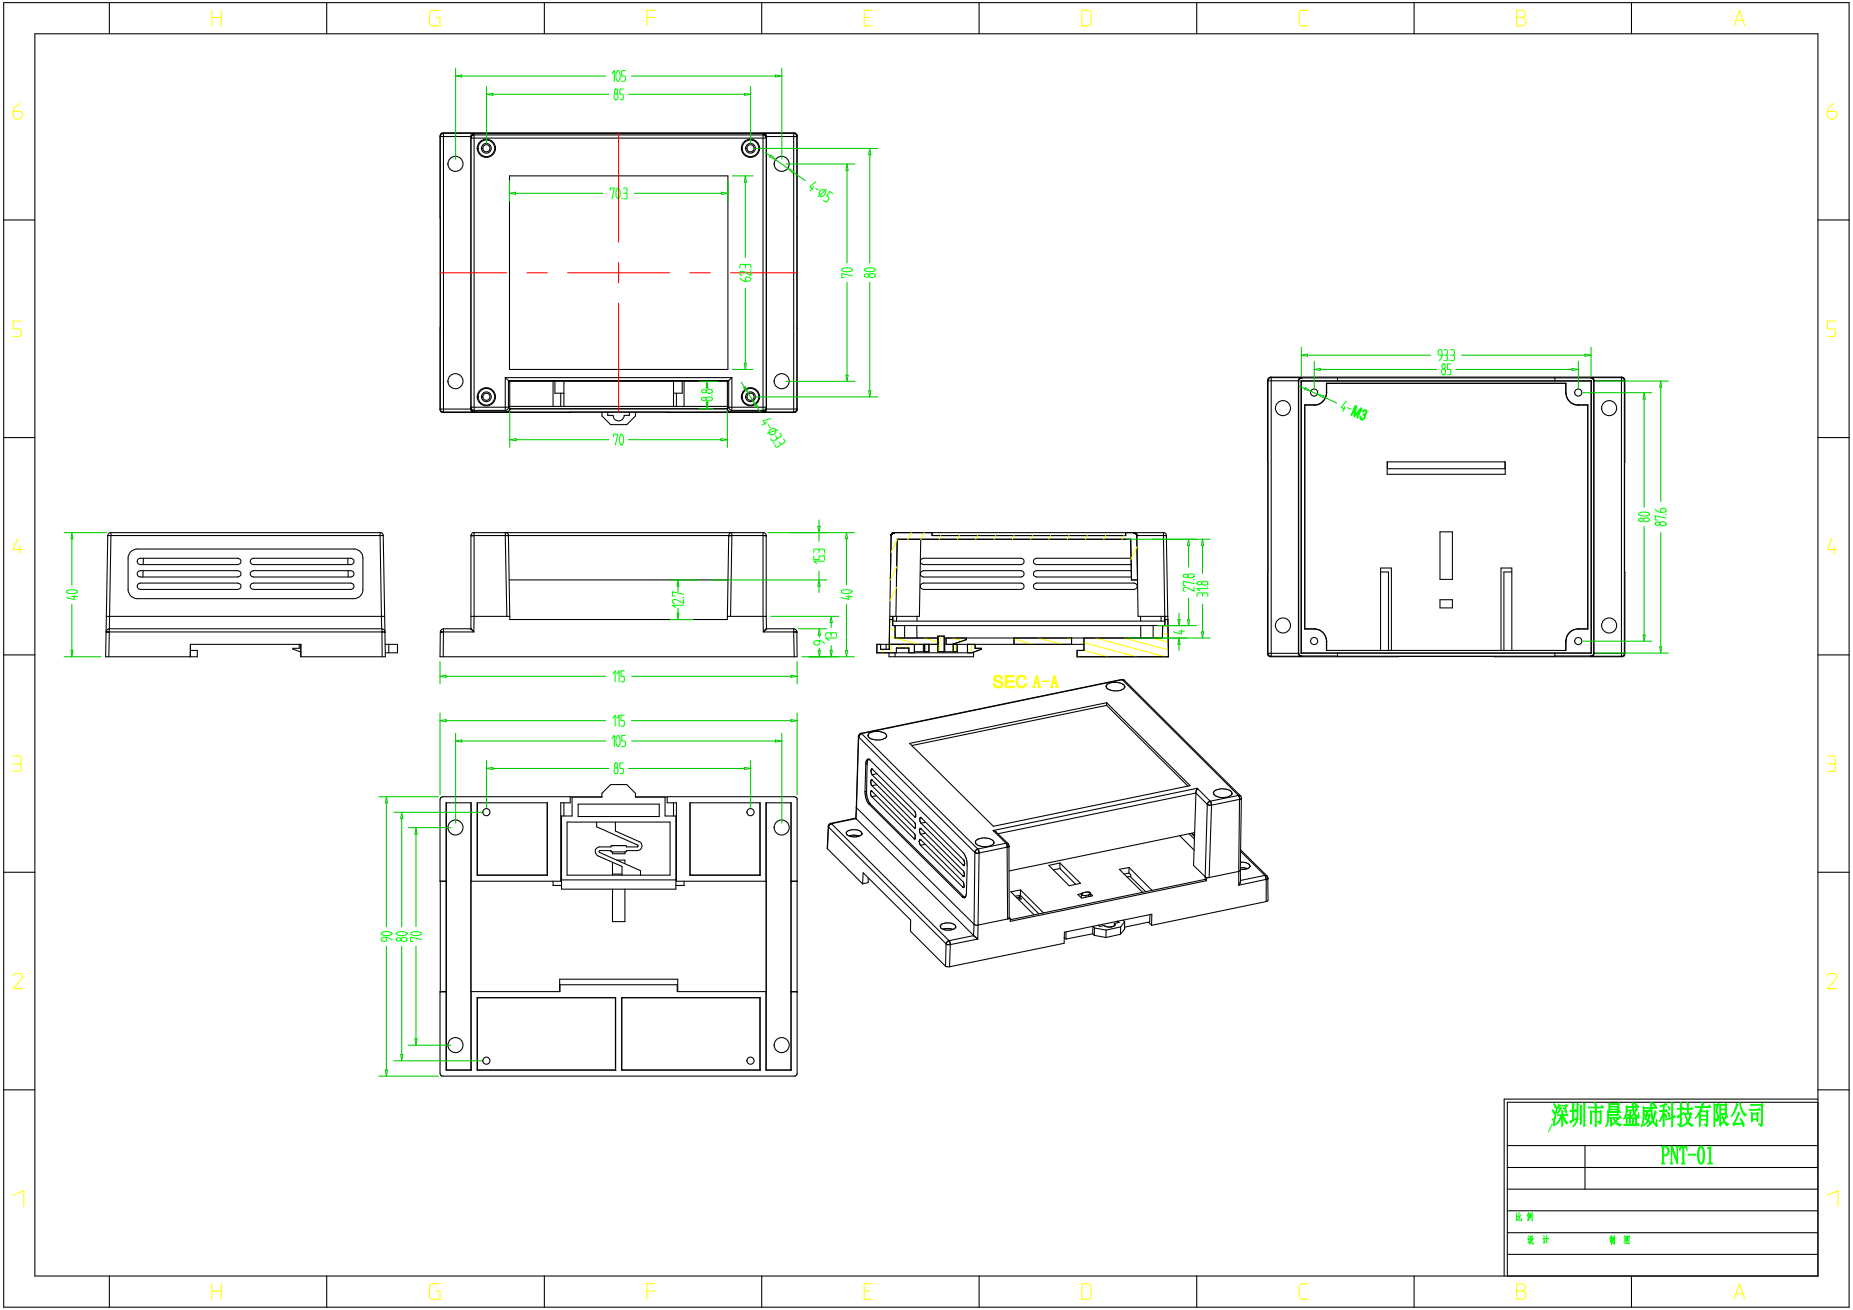
[picture p49: page 1]
