majicdata6/ir_bingobox_2018/project/Prudoction/[BingoBin]产品标贴样版_171220.pdf

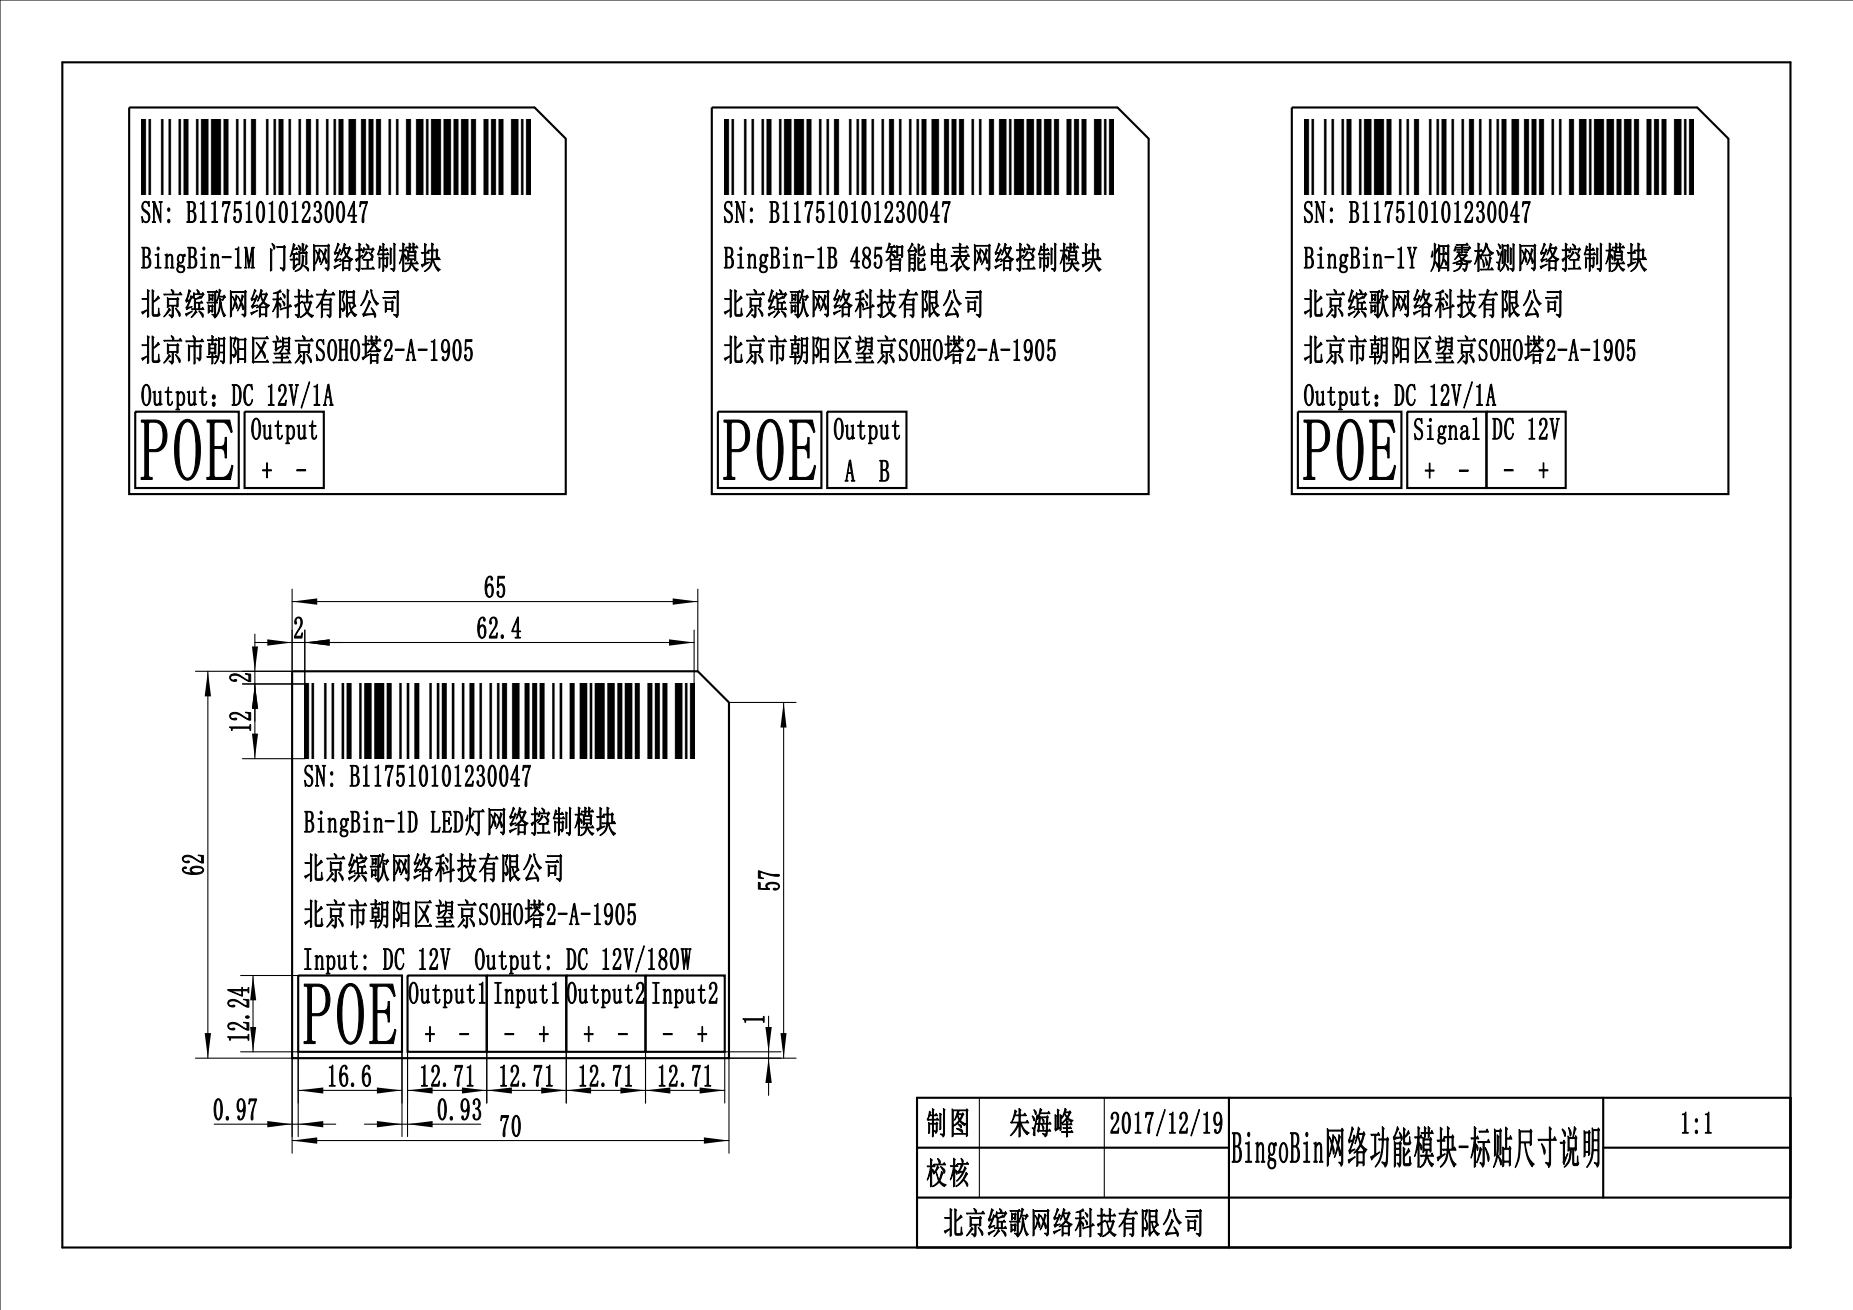
[picture p50: page 1]
