majicdata6/ir_bingobox_2018/project/Prudoction/原理图/[BingoBin]硬件设计原理图_V1.0.10_180108.PDF

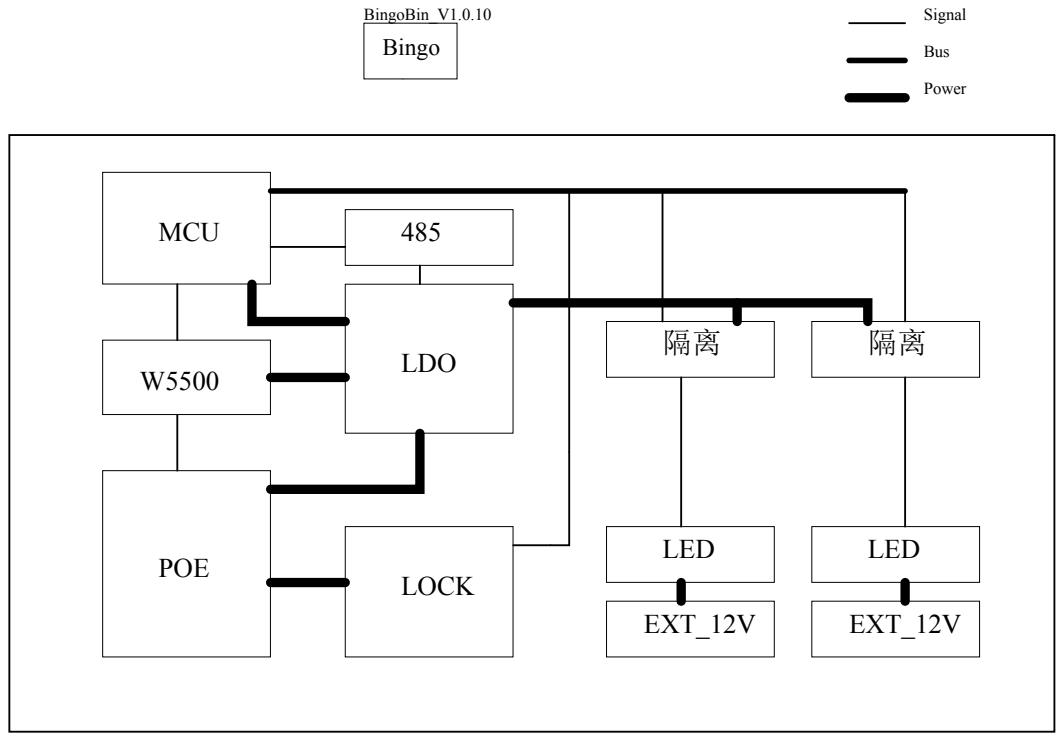
[picture p51: page 1]

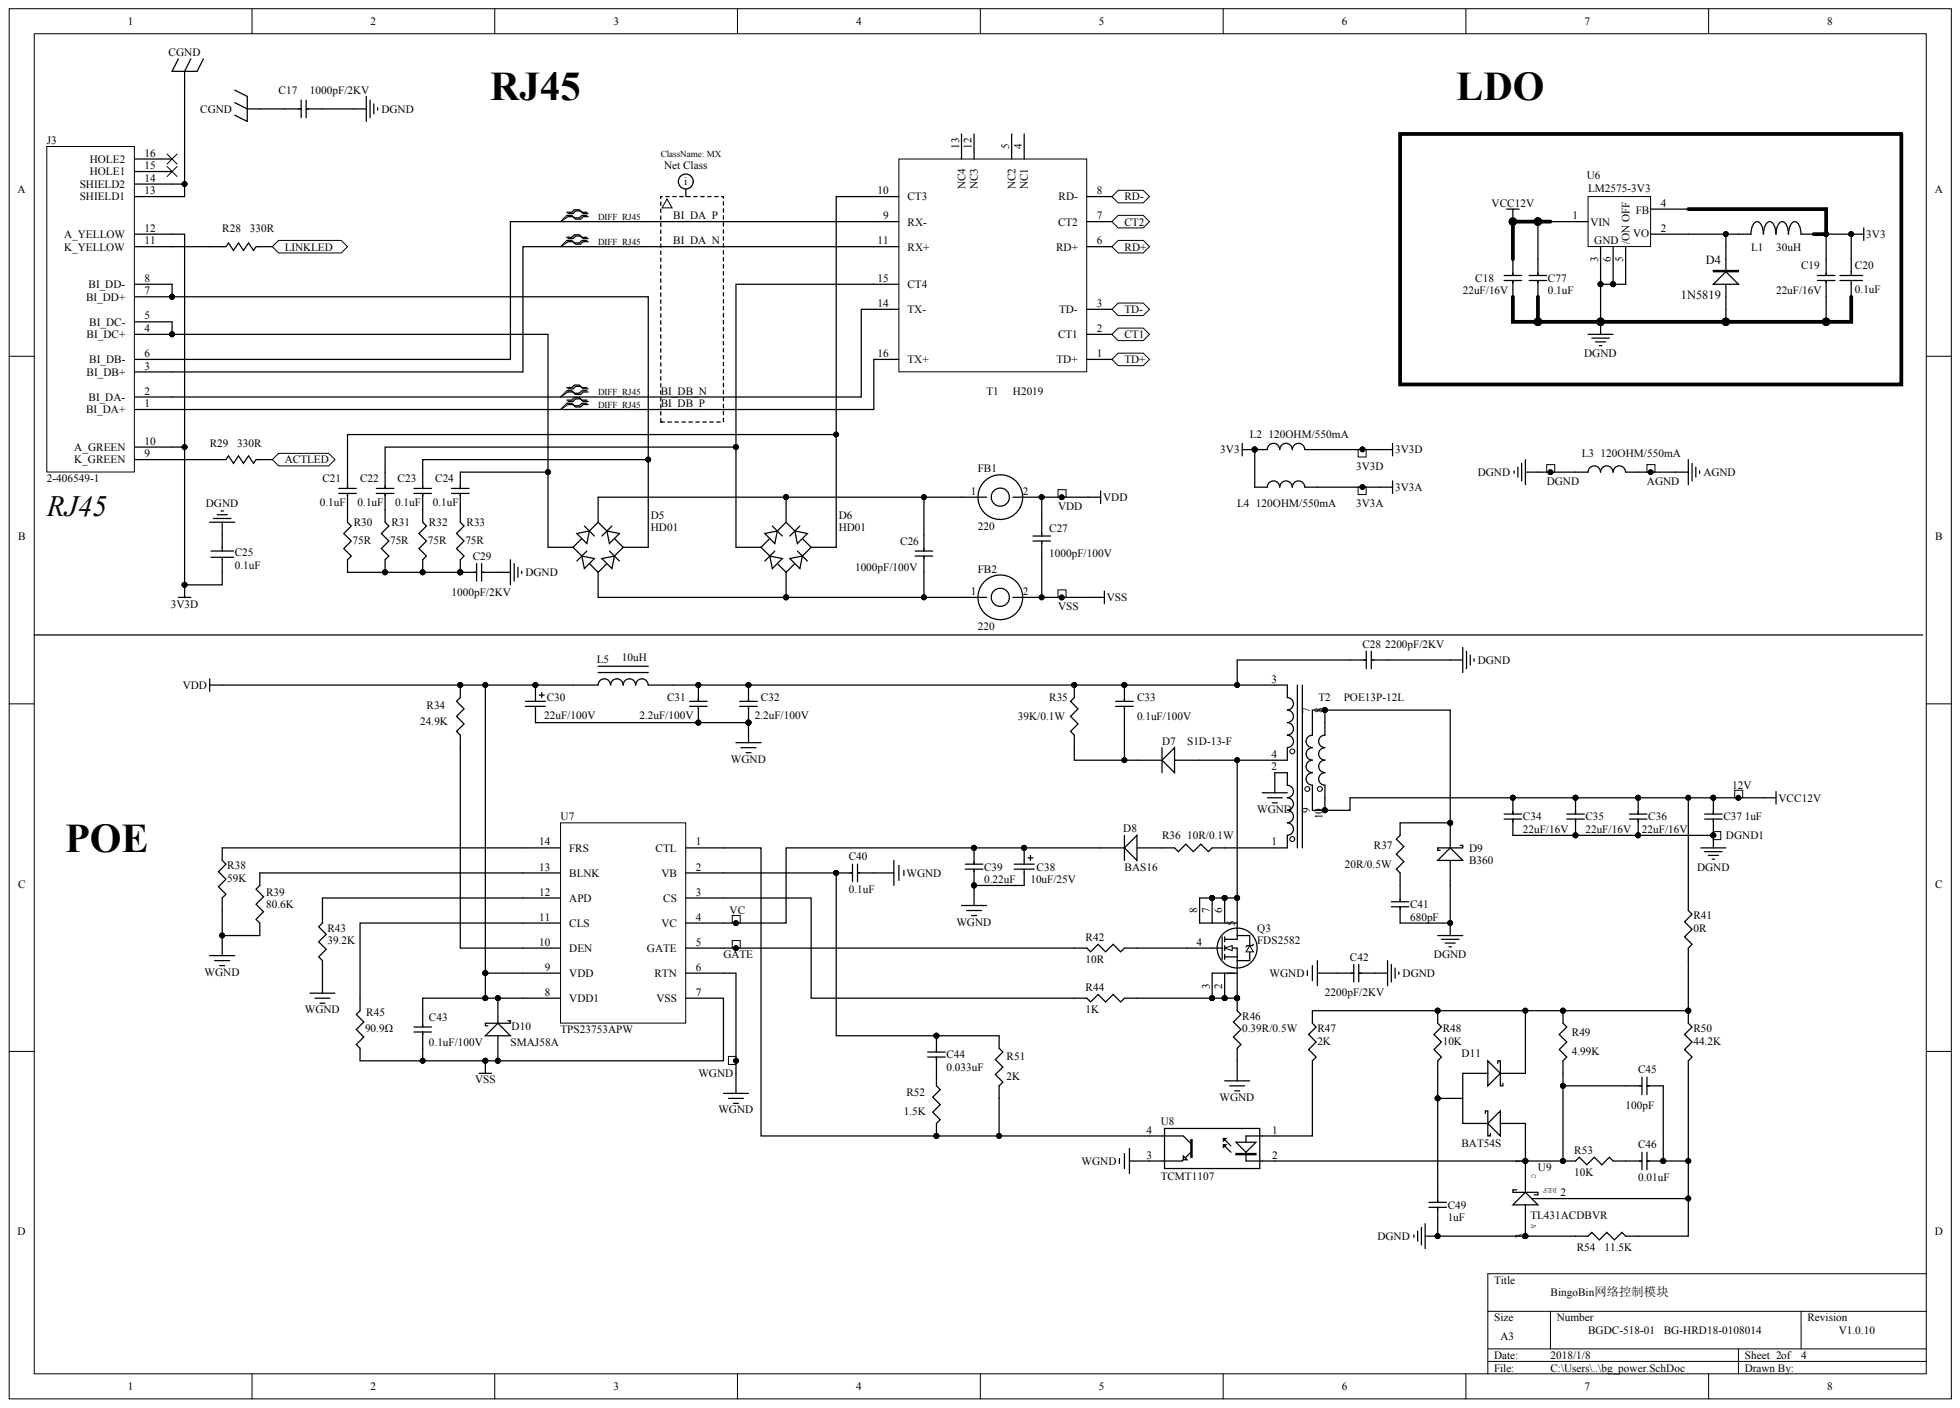
[picture p52: page 2]

1 | | BAT54S

U9 | 10K 0.01uF 2 FER

TL431ACDBVR

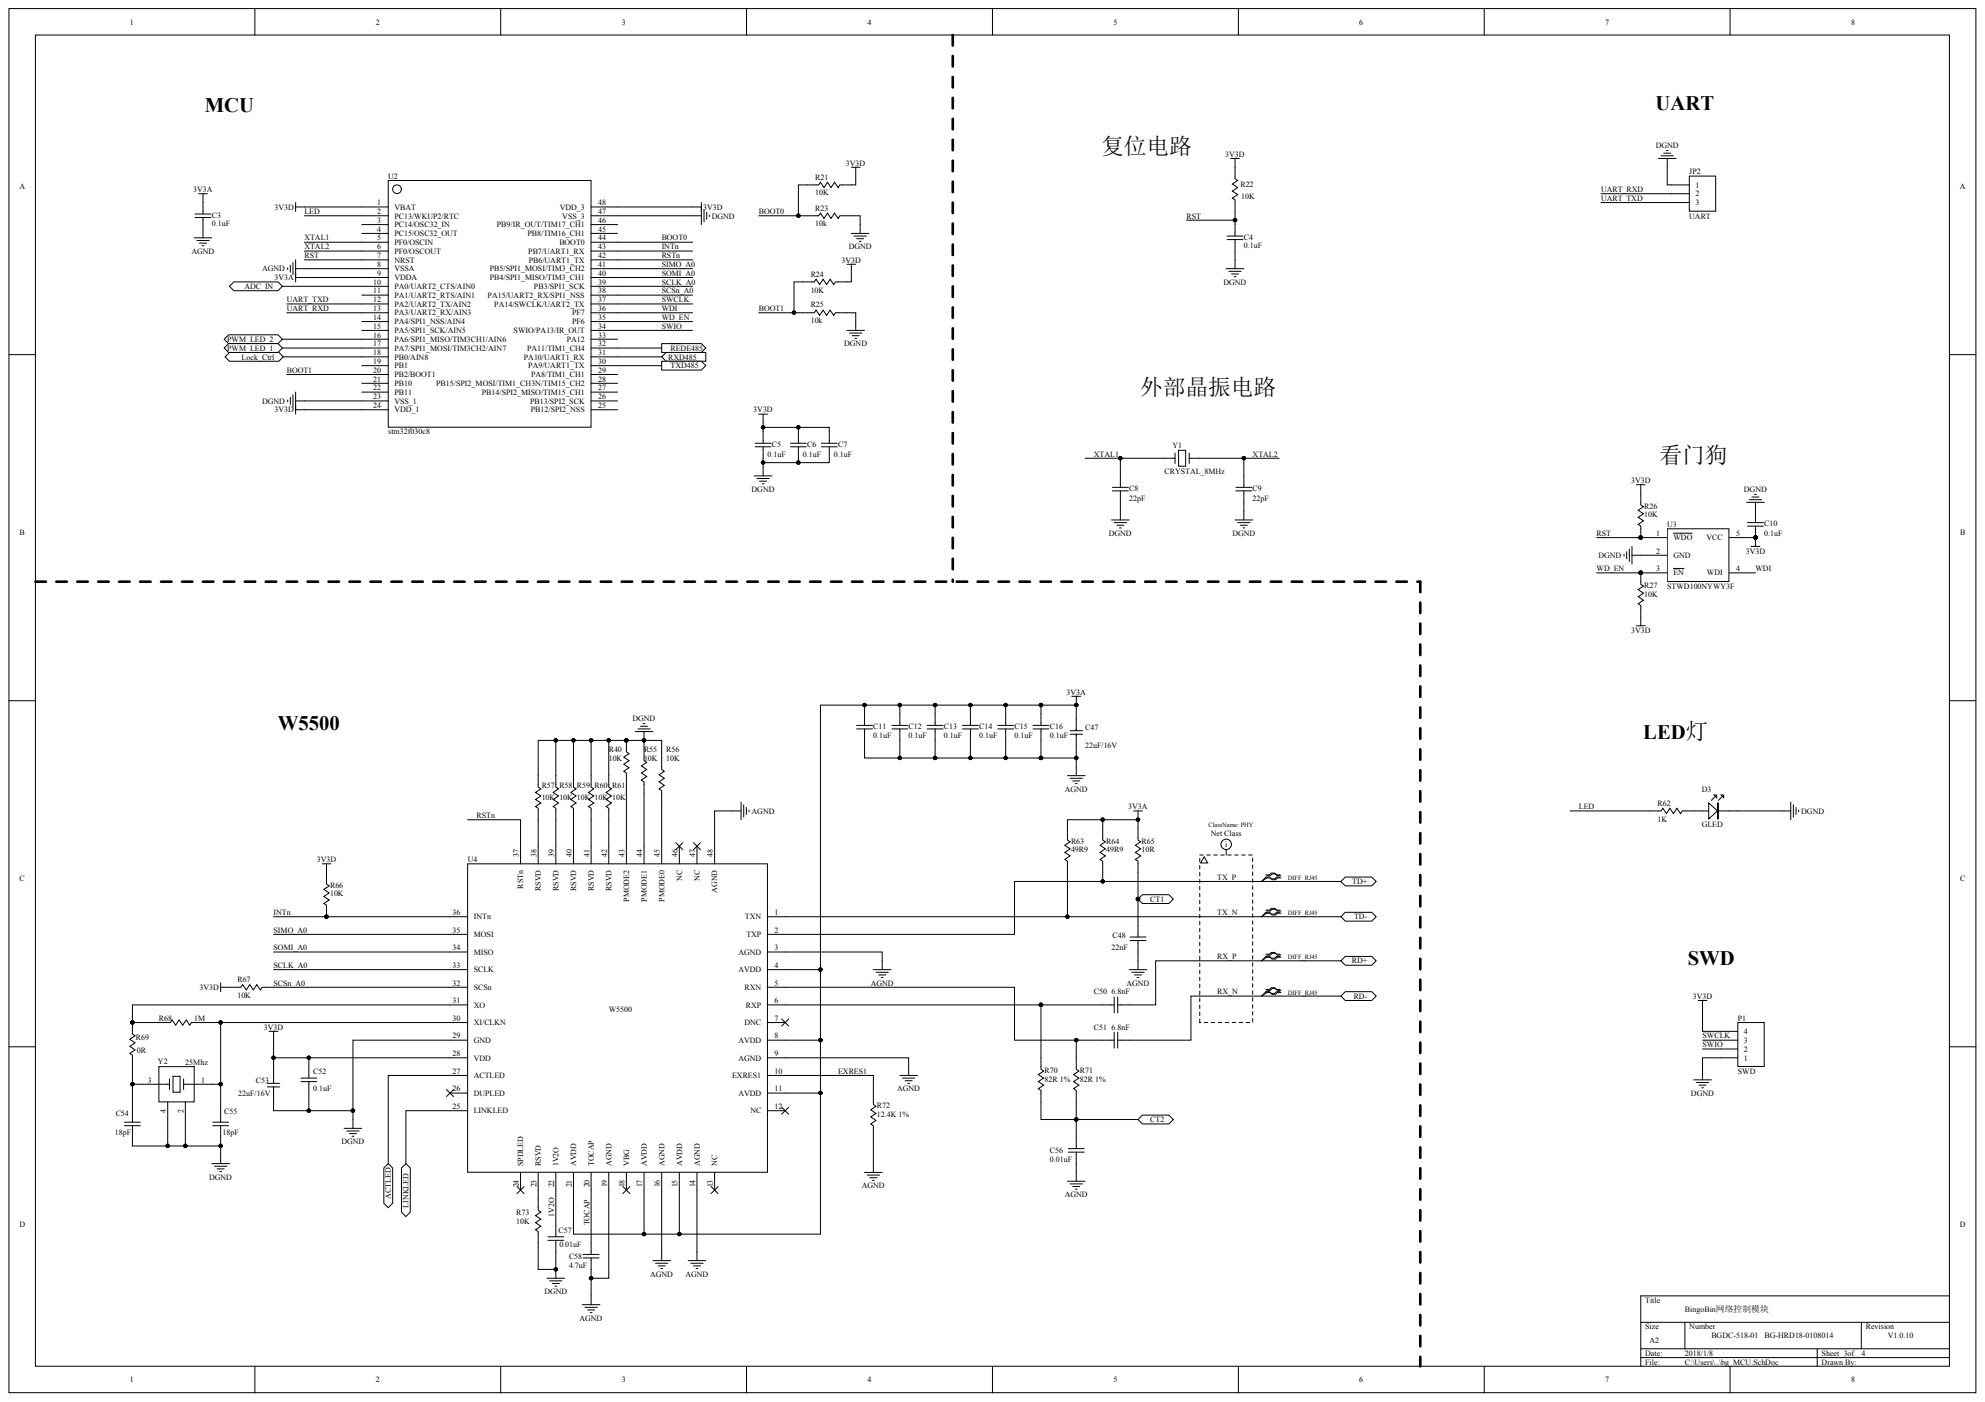
[picture p53: page 3]

R68 1M | | XI/CLKN 30 | 7

C52 0.1uF | | ACTLED 27

DUPLED 26

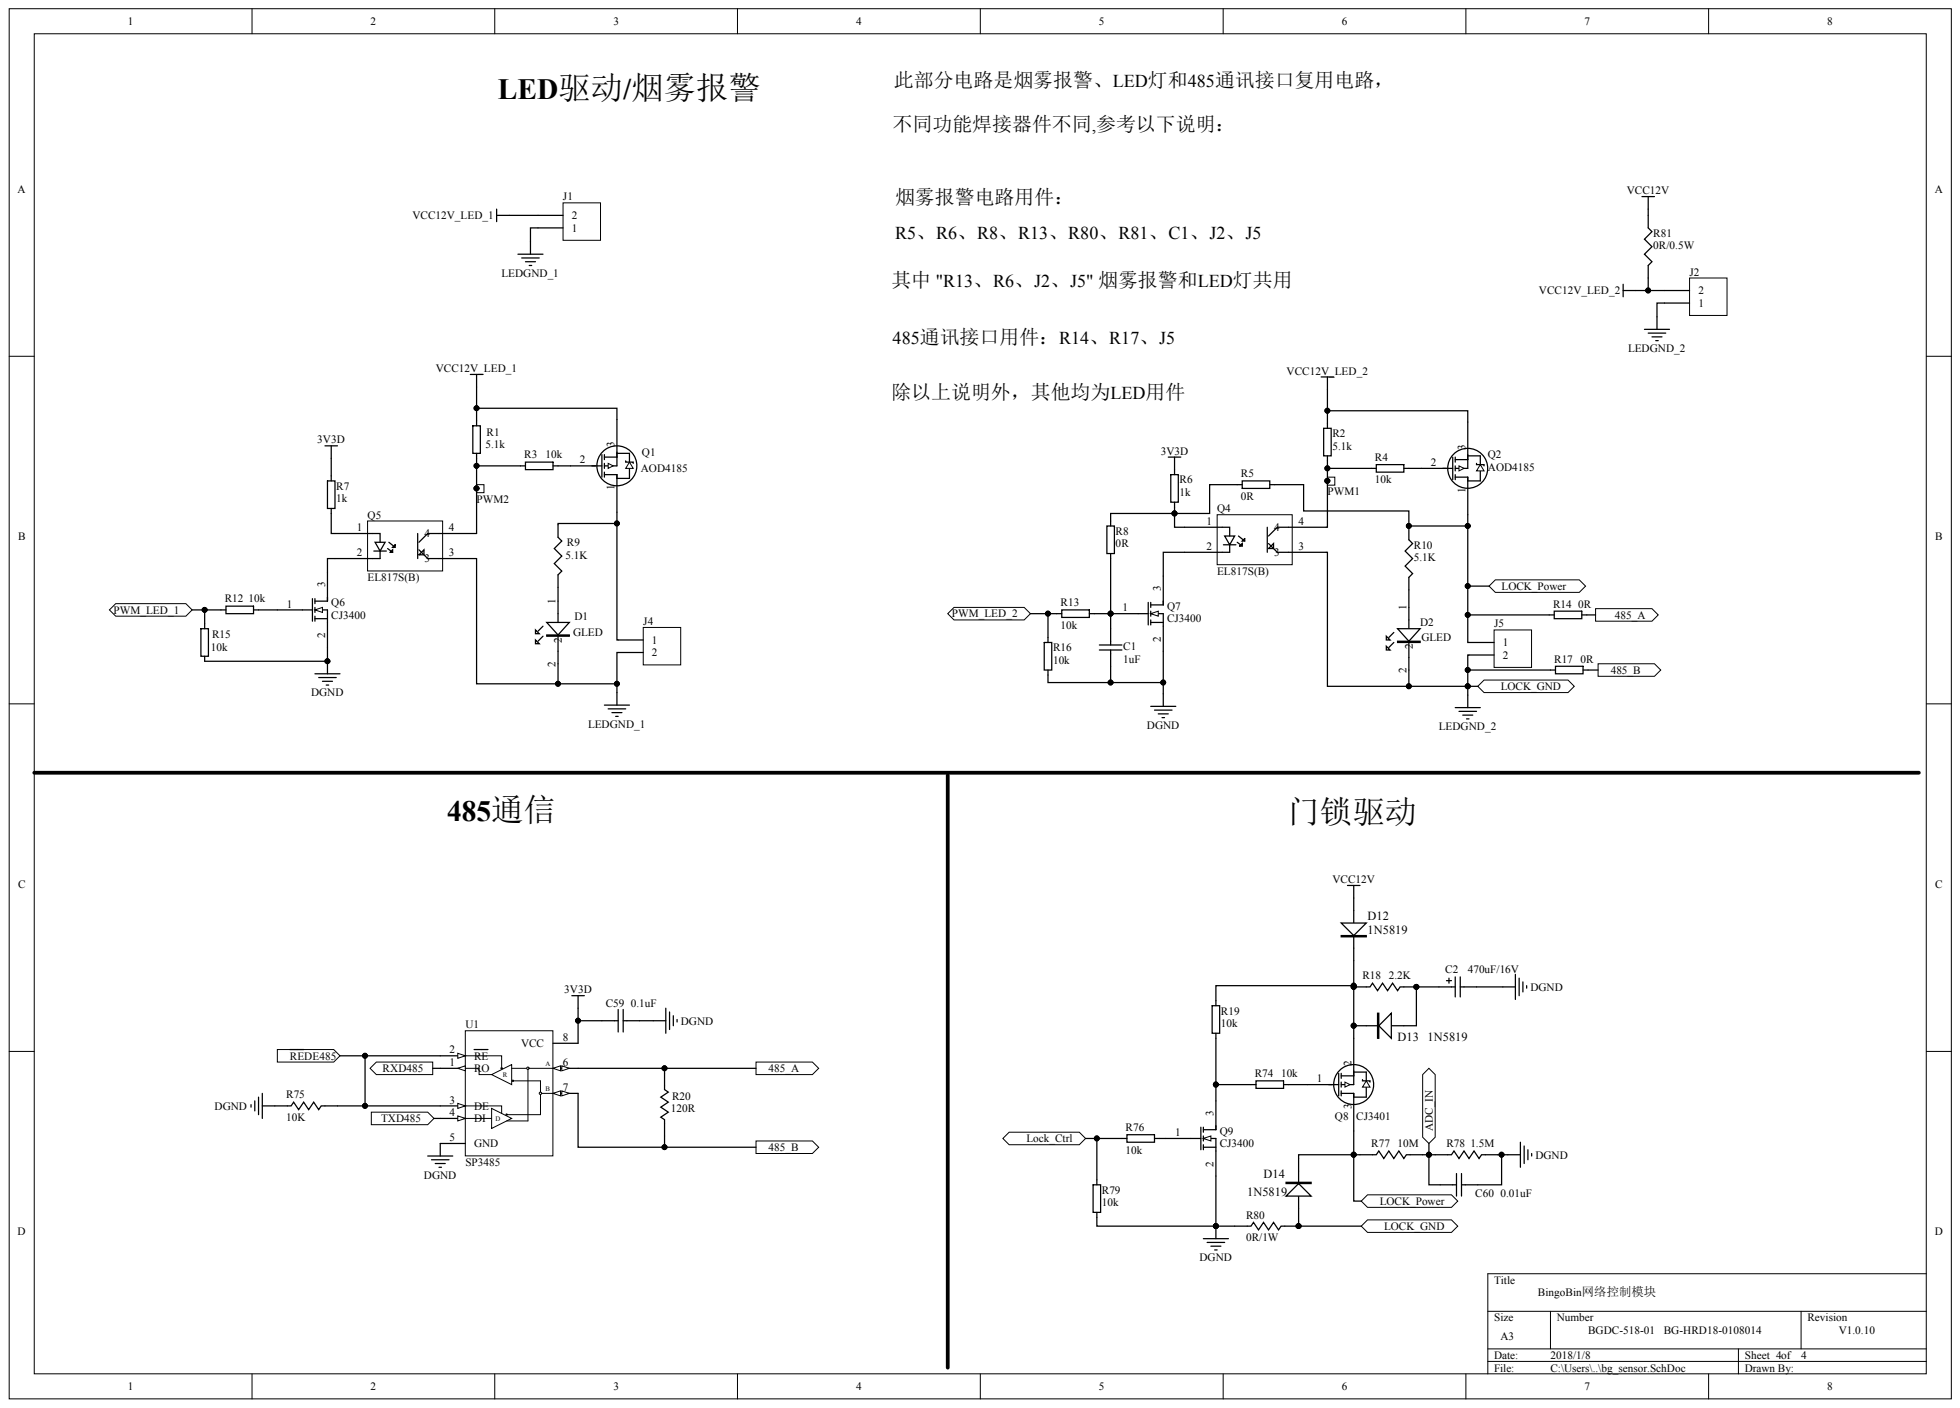
[picture p54: page 4]
