majicdata6/ir_bingobox_2018/(list of files, drawings)

Other design files:
project/Design/HW/SchPcb-1A/bg_MCU.SchDoc
project/Design/HW/SchPcb-1A/bg_per.PrjPcb
project/Design/HW/SchPcb-1A/bg_power.SchDoc
project/Design/HW/SchPcb-1A/bg_sensor.SchDoc
project/Design/HW/SchPcb-1A/view.SchDoc
project/Design/HW/SchPcb/bg_MCU.SchDoc
project/Design/HW/SchPcb/bg_per.PrjPcb
project/Design/HW/SchPcb/bg_power.SchDoc
project/Design/HW/SchPcb/bg_sensor.SchDoc
project/Design/HW/SchPcb/view.SchDoc
