majicdata6/ir_bingobox_2018/code/Application/Inc/app_info.h

/*-----------------------------------------------------------------------------
Copyright 2017 - 2020, BingoBox Inc.
License     : Internal Use.
Author      : ??
Description : ????????????????
-----------------------------------------------------------------------------*/

#ifndef BINGOBIN_APPLICATION_INFO_H_
#define BINGOBIN_APPLICATION_INFO_H_
/* Includes ------------------------------------------------------------------*/
#include "stm32f0xx_hal.h"
/*---------------------------------------------------------------------------*/
//	Global Defines and Macros

/*---------------------------------------------------------------------------*/

/*---------------------------------------------------------------------------*/
//	Global Types and Enums
/*---------------------------------------------------------------------------*/

/*---------------------------------------------------------------------------*/
//	Global Constants
/*---------------------------------------------------------------------------*/

/*---------------------------------------------------------------------------*/
//	Global Variables
/*---------------------------------------------------------------------------*/

/*---------------------------------------------------------------------------*/
//	Global Function prototypes
/*---------------------------------------------------------------------------*/
/*-----------------------------------------------------------------------------
Prototype  : Info_MemoryInit()
Parameters : void
Return     : void
Function   : info memory?????
-----------------------------------------------------------------------------*/
void Info_MemoryInit(void);

/*---------------------------------------------------------------------------*/
//	Global Function prototypes
/*---------------------------------------------------------------------------*/
/*-----------------------------------------------------------------------------
Prototype  : Info_WriteIp()
Parameters : uint8_t *ip_info
Return     : void
Function   : ??IP??
-----------------------------------------------------------------------------*/
void Info_WriteIp(uint8_t *ip_info);

/*---------------------------------------------------------------------------*/
//	Global Function prototypes
/*---------------------------------------------------------------------------*/
/*-----------------------------------------------------------------------------
Prototype  : Info_WriteLockTimer()
Parameters : uint16_t *timer_info
Return     : void
Function   : ???????
-----------------------------------------------------------------------------*/
void Info_WriteLockTimer(uint16_t *timer_info);

/*---------------------------------------------------------------------------*/
//	Global Function prototypes
/*---------------------------------------------------------------------------*/
/*-----------------------------------------------------------------------------
Prototype  : Info_WriteLightLevel()
Parameters : char *level_info
Return     : void
Function   : ????????
-----------------------------------------------------------------------------*/
void Info_WriteLightLevel(uint8_t lightbox_type,char *level_info);

/*---------------------------------------------------------------------------*/
//	Global Function prototypes
/*---------------------------------------------------------------------------*/
/*-----------------------------------------------------------------------------
Prototype  : Info_ReadHardVer()
Parameters : char *hard_info
Return     : void
Function   : ??info memory?????
-----------------------------------------------------------------------------*/
void Info_ReadHardVer(char *hard_info);

/*---------------------------------------------------------------------------*/
//	Global Function prototypes
/*---------------------------------------------------------------------------*/
/*-----------------------------------------------------------------------------
Prototype  : Info_ReadSoftVer()
Parameters : char *soft_info
Return     : void
Function   : ??info memory?????
-----------------------------------------------------------------------------*/
void Info_ReadSoftVer(char *soft_info);

/*---------------------------------------------------------------------------*/
//	Global Function prototypes
/*---------------------------------------------------------------------------*/
/*-----------------------------------------------------------------------------
Prototype  : Info_ReadIp()
Parameters : uint8_t *ip_info
Return     : void
Function   : ??ip??
-----------------------------------------------------------------------------*/
void Info_ReadIp(uint8_t *ip_info);

/*---------------------------------------------------------------------------*/
//	Global Function prototypes
/*---------------------------------------------------------------------------*/
/*-----------------------------------------------------------------------------
Prototype  : Info_ReadTimer()
Parameters : uint16_t *timer_info
Return     : void
Function   : ??info memory?????
-----------------------------------------------------------------------------*/
void Info_ReadTimer(uint16_t *timer_info);

/*---------------------------------------------------------------------------*/
//	Global Function prototypes
/*---------------------------------------------------------------------------*/
/*-----------------------------------------------------------------------------
Prototype  : Info_ReadLevel()
Parameters : uint8_t *level_info
Return     : void
Function   : ??info memory?????
-----------------------------------------------------------------------------*/
void Info_ReadLevel(uint8_t lightbox_type,uint8_t *level_info);
void printf_array(uint8_t *array,uint8_t size);
#endif /* End of <PROJECT>_<PATH>_<FILE>_H_ */
