majicdata6/ir_bingobox_2018/(notices)

Notices in the files:
code/Application/Inc/app_w5500.h:
License :ÄÚ²¿
